carlosoliveirajesus/datalogger/hw-datalogger/fabricacao/BOM/Bill of Materials-datalogger.xlsx

Name | Description | Designator | Footprint | LibRef | Quantity
GRM219R61E475KA73D | Chip Multilayer Ceramic Capacitors for General Purpose, 0805, 4.7uF, X5R, 15%, 10%, 25V | C1 | FP-GRM219-0_15-0_1-IPC_C | CMP-06035-041247-1 | 1
GRM21BZ71E106KE15K | Chip Multilayer Ceramic Capacitors for General Purpose, 0805, 10uF, X7R, 15%, 10%, 25V | C2, C3, C4, C10, C22, C24 | FP-GRM21B-0_2-e0_2_0_7-IPC_B | CMP-06035-042430-1 | 6
CC0603KRX7R9BB104 | CAP CER 0.1UF 50V X7R 0603 | C5, C6, C9, C11, C12, C18, C19, C20, C21, C23, C26, C27, C28, C29, C30 | FP-CC0603-DA-MFG | CMP-2100-03601-2 | 15
C0402C829D5GACTU | CAP CER 8.2PF 50V C0G/NP0 0402 | C7, C8 | FP-C0402-BB-MFG | CMP-1034-00609-3 | 2
CC0603KRX7R7BB225 | CAP CER 2.2UF 16V X7R 0603 | C13, C14, C25 | FP-CC0603-DA-MFG | CMP-03422-001238-1 | 3
C0402C100C5GACTU | CAP CER 10PF 50V NP0 0402 | C15, C16 | FP-C0402-BB-MFG | CMP-2008-03045-2 | 2
GCM188R71E105KA64D |  | C17 | FP-GCM188-0_1-MFG | CMP-2006-02363-4 | 1
B5819W | Schottky Barrier Rectifier, 40 V, 1 A, -65 to 125 degC, 2-Pin SOD123, RoHS, Tape and Reel | D1 | MCC-SOD123_V | CMP-004-00005-2 | 1
APT1608SGC | Super Bright Green LED, 62.5 mW, 25 mA, -40 to 85 degC, 2-Pin SMD, RoHS, Tape and Reel | D2 | KING-APT1608SGC_V | CMP-2000-05789-1 | 1
APT1608EC | LED RED CLEAR CHIP SMD | D3 | FP-APT1608EC-MFG | CMP-2000-05179-2 | 1
APT1608QBC/D | LED BLUE CLEAR CHIP SMD | D4 | FP-APT1608QBC-D-MFG | CMP-2000-05788-2 | 1
BLM18PG221SH1D | Chip Ferrite Bead, 0603, 220Ω @ 100MHz, 0.1Ω, 25%, 1.4A | FB1 | FP-BLM18-0_15-t0_8-IPC_C | CMP-06046-000201-1 | 1
USB4105-GF-A | Conector USB-C 2.0, receptáculo de 16 pinos, montagem SMT/TH | J1 | GCT_USB4105-GF-A | USB4105-GF-A | 1
61300611121 | THT Vertical Pin Header WR-PHD, Pitch 2.54 mm, Single Row, 6 pins | J2 | 61300611121 | CMP-1502-01070-4 | 1
61300411121 | THT Vertical Pin Header WR-PHD, Pitch 2.54 mm, Single Row, 4 pins | J3 | 61300411121 | CMP-1502-01064-4 | 1
DM3AT-SF-PEJM5 | CONN MICRO SD CARD PUSH-PUSH R/A | J4 | FP-DM3AT-SF-PEJM5-MFG | CMP-2000-05150-2 | 1
VLS3012HBX-2R2M | FIXED IND 2.2UH 3.15A 106 MOHM | L1 | FP-VLS3012HBX-MFG | CMP-08253-000022-1 | 1
LQM21PN2R2MGHL | Multilayer Type Inductor for Power Lines, 0805 (2012), 2.2μH, 20%, 0.156Ω, 1.7A | L2 | FP-LQM21PH_G0-IPC_C | CMP-06042-014073-1 | 1
S2B-PH-SM4-TB(LF)(SN) | Male Header, Pitch 2 mm, 1 x 2 Position, Height 5.5 mm, -25 to 85 degC, RoHS, Tape and Reel | P1 | JST- S2B-PH-SM4-TB(LF)(SN)-2_V | CMP-002-00031-2 | 1
DMG2305UX-13 | MOSFET P-CH 20V 4.2A SOT23 | Q1 | FP-SOT23-MFG | CMP-12801-000021-1 | 1
RC0603FR-07100RL |  | R1 | FP-RC0603-0_55-MFG | CMP-2100-03663-2 | 1
RC0603FR-07100KL | RES SMD 100K OHM 1% 1/10W 0603 | R2, R5, R6 | FP-RC0603-0_55-MFG | CMP-2100-03662-2 | 3
RC0603FR-075K1L |  | R3, R4 | RESC1608X55X25ML10T15 | CMP-2000-04091-1 | 2
RC0603FR-0710KL | RES 10K OHM 1% 1/10W 0603 | R7, R18 | FP-RC0603-0_55-IPC_C | CMP-2100-03664-2 | 2
RC0603FR-074K7L | Chip Resistor, 4.7 KOhm, +/- 1%, 0.1 W, -55 to 155 degC, 0603 (1608 Metric), RoHS, Tape and Reel | R8, R9 | RESC1608X55X25LL10T15 | CMP-2000-06942-1 | 2
RC0603FR-0747KL | RES SMD 47K OHM 1% 1/10W 0603 | R10, R11, R12, R13, R14, R15 | FP-RC0603FR-0747KL-MFG | CMP-1659-00055-2 | 6
RC0603FR-0733RL | Chip Resistor, 33 Ohm, +/- 1%, 0.1 W, -55 to 155 degC, 0603 (1608 Metric), RoHS, Tape and Reel | R16 | RESC1608X55X25LL10T15 | CMP-2000-06939-1 | 1
RC0603FR-071KL | RES 1K OHM 1% 1/10W 0603 | R17, R19 | FP-RC0603-0_55-IPC_C | CMP-1659-00009-5 | 2
RT0603FRE07330RL | RES SMD 330 OHM 1% 1/10W 0603 | R20 | FP-RT0603-MFG | CMP-03412-006947-1 | 1
JS102011SAQN | SWITCH SLIDE SPDT 300MA 6V | SW1 | FP-JS102011SAQN-MFG | CMP-2000-06501-2 | 1
B3U-1000P | Tactile Switch, SPST-NO, 0.05 A, 12 V, -25 to 70 degC, 2-Pin SMD, RoHS, Tape and Reel | SW2, SW3, SW4 | OMRON-B3U-1000_V | CMP-011-00000-2 | 3
TPS63001DRCRG4 | Buck-Boost Voltage Converter with 1.8 to 5.5 V Input and 3.3 V Output, -40 to 85 degC, 10-Pin SON (DRC), Green (RoHS & no Sb/Br) | U1 | DRC10-2400X1650TP | CMP-0345-00003-1 | 1
USBLC6-2SC6 | 17V Clamp 5A (8/20Âµs) Ipp Tvs Diode Surface Mount SOT-23-6 | U2 | SOT95P280X145-6N | USBLC6-2SC6 | 1
STM32U5A5RJT6Q | ARM Microcontrollers - MCU Ultra-low-power FPU Arm Cortex-M33 MCU TrustZone, 160 | U3 | LQFP64-5W_MFG | CMP-00355-135308217-1 | 1
LSM6DSOXTR | INEMO INERTIAL MODULE: 3D ACCELE | U4 | FP-LGA-14L-DM00249496-MFG | CMP-12177-000010-1 | 1
BME280 | SENSOR PRESSURE HUMIDITY TEMP | U5 | FP-BME280-MFG | CMP-2000-05073-3 | 1
ABS07-32.768KHZ-7-T | Crystal 32.768kHz ±20ppm (Tol) 7pF FUND 70kΩ 2-Pin CSMD T/R | Y1 | FP-ABS07-MFG | CMP-27762-014373-1 | 1
ABM11W-16.0000MHZ-8-K1Z-T3 | Crystal 16MHz ±10ppm 8pF SMD-4 2mm x 1.6mm | Y2 | FP-ABM11W-MFG | CMP-27762-006513-1 | 1
