carlosoliveirajesus/datalogger/hw-datalogger/fabricacao/ExportSTEP/PCB_A1.step

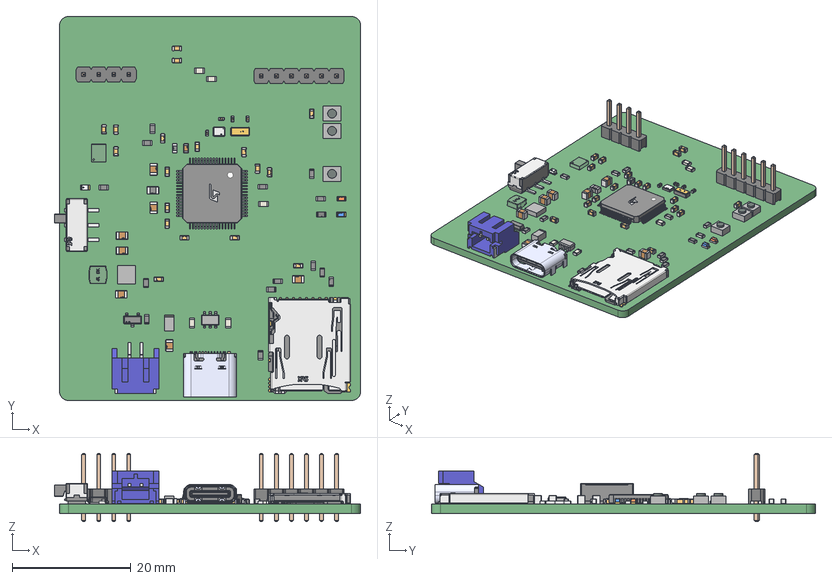
[picture p25: CAD file, 2026-10-22]
hw-datalogger/fabricacao/ExportSTEP/PCB_A1.step
51.7 x 64.8 x 11.5 mm
terminals x 8
logo x 4
Crys_Abracon_ABM11W-16_0132MHZ-4-J1Z-T3_eec x 6
Package
Leads
LID
Logo
leads
STMicroelectronics
circle
STMicroelectronics STM32F303RET61
STMicroelectronics STM32F303RET62 x 64
STM ll
Extruded x 22
shield
actuator
RT0603BRD07104KL_Ceramic
RT0603BRD07104KL_Terminal x 2
RT0603BRD07104KL_Coating
RT0603BRD07104KL_Logo
Yageo Logo x 14
pins
part number & logo
S2B-PH-SM4-TB
plat1
plat2
sides
TDK Logo
DM3AT-SF-PEJM5
Hirose Logo adjastable
6130xx11121_PIN x 10
USB4105GFA_USB4105GFA
side x 16
Murata x 8
base x 2
lens x 2
cathode mark x 2
APT1608
name x 18
Murata Logo 3
value x 4
