carlosoliveirajesus/datalogger/hw-datalogger/fabricacao/dataloggerOutJob.PDF

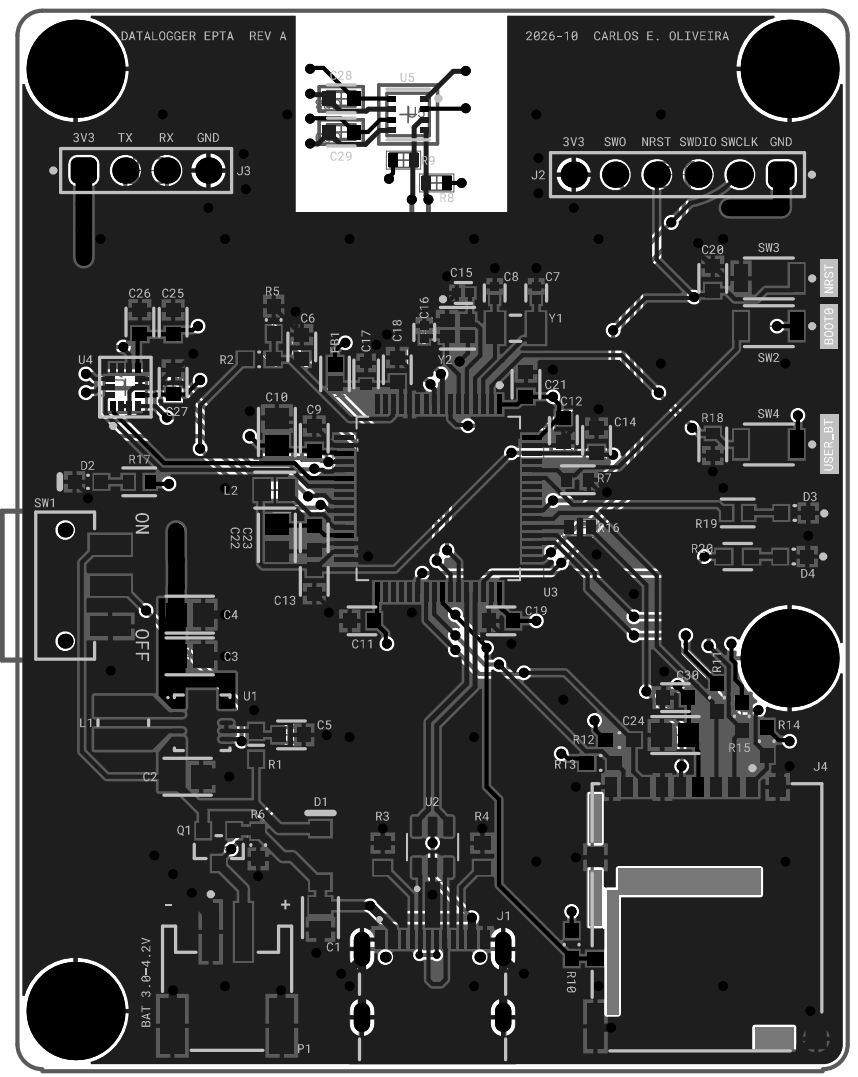
[picture p26: page 1]

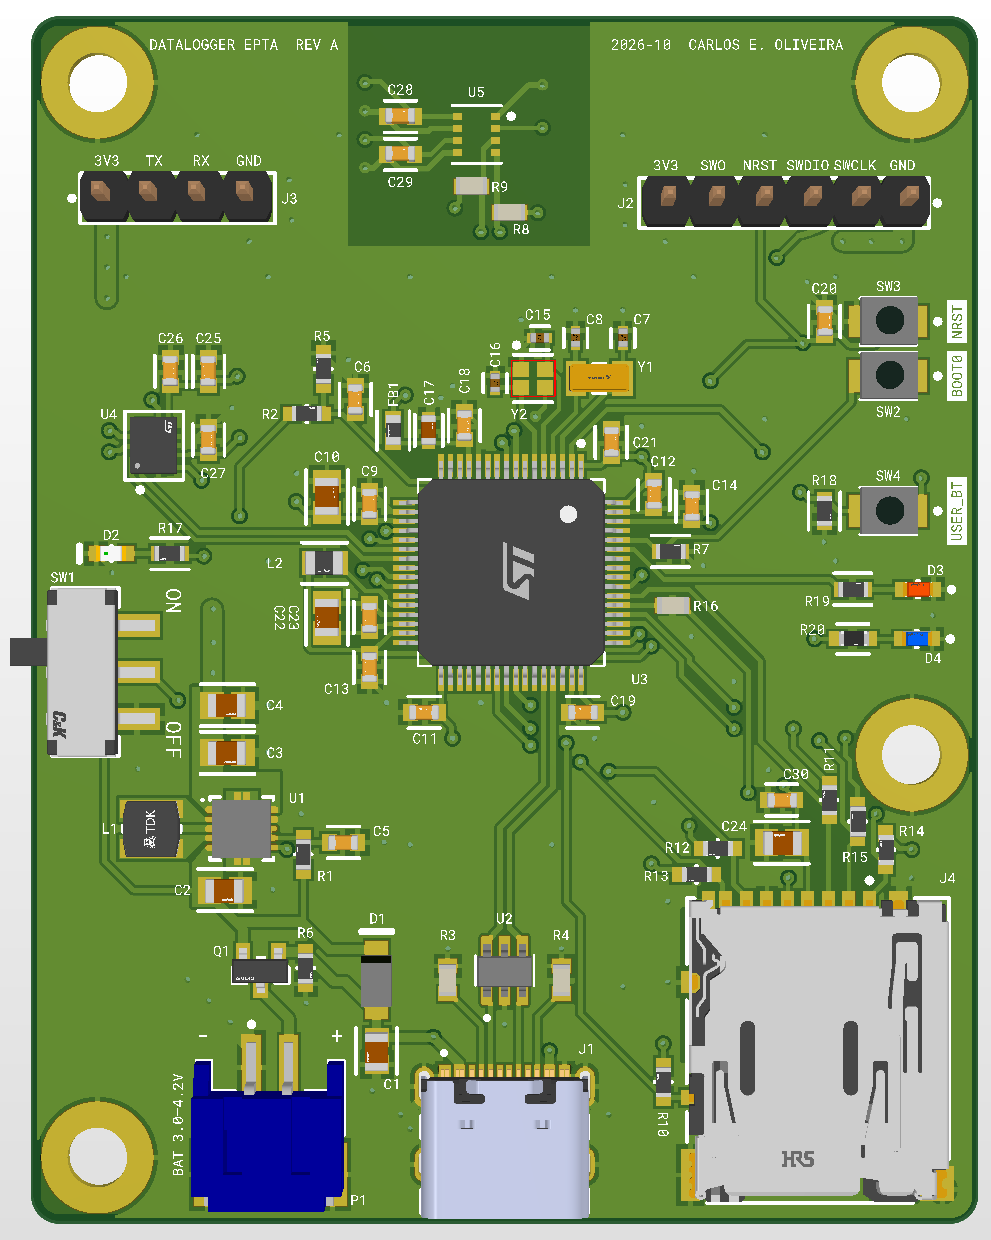
[picture p27: page 2]

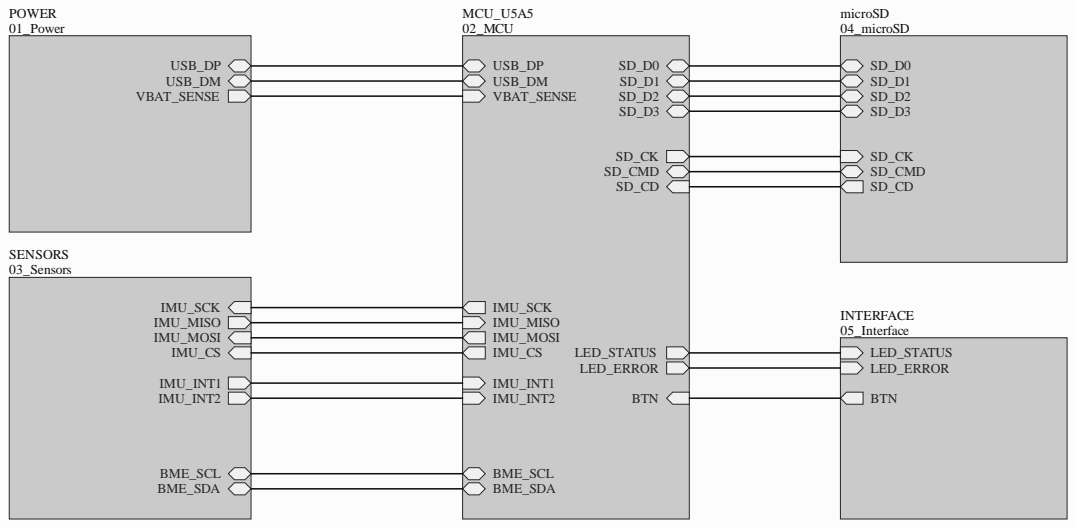
[picture p28: page 3]

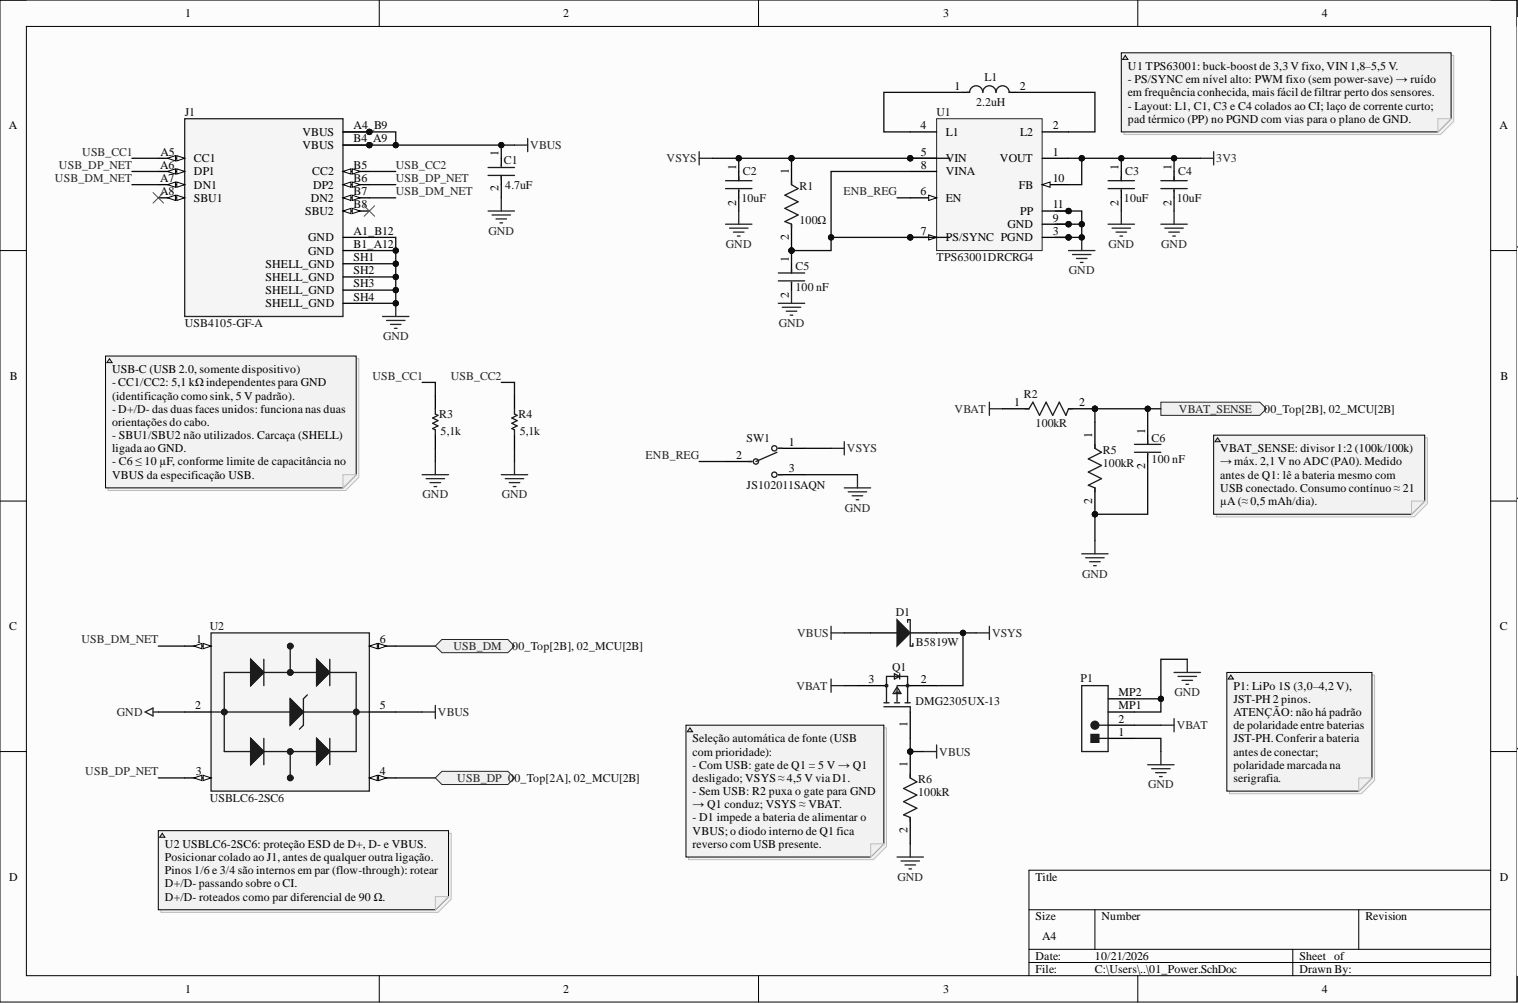
[picture p29: page 4]

U1 TPS63001: buck-boost de 3,3 V fixo, VIN 1,8–5,5 V.
- PS/SYNC em nível alto: PWM fixo (sem power-save) → ruído
em frequência conhecida, mais fácil de filtrar perto dos sensores.
- Layout: L1, C1, C3 e C4 colados ao CI; laço de corrente curto;
pad térmico (PP) no PGND com vias para o plano de GND.

USB-C (USB 2.0, somente dispositivo)
- CC1/CC2: 5,1 kΩ independentes para GND
(identificação como sink, 5 V padrão).
- D+/D- das duas faces unidos: funciona nas duas
orientações do cabo.
- SBU1/SBU2 não utilizados. Carcaça (SHELL)
ligada ao GND.
- C6 ≤ 10 µF, conforme limite de capacitância no
VBUS da especificação USB.

VBAT_SENSE: divisor 1:2 (100k/100k)
→ máx. 2,1 V no ADC (PA0). Medido
antes de Q1: lê a bateria mesmo com
USB conectado. Consumo contínuo ≈ 21
µA (≈ 0,5 mAh/dia).

P1: LiPo 1S (3,0–4,2 V),
JST-PH 2 pinos.
ATENÇÃO: não há padrão
de polaridade entre baterias
JST-PH. Conferir a bateria
antes de conectar;
polaridade marcada na
serigrafia.

Seleção automática de fonte (USB
com prioridade):
- Com USB: gate de Q1 = 5 V → Q1
desligado; VSYS ≈ 4,5 V via D1.
- Sem USB: R2 puxa o gate para GND
→ Q1 conduz; VSYS ≈ VBAT.
- D1 impede a bateria de alimentar o
VBUS; o diodo interno de Q1 fica
reverso com USB presente.

U2 USBLC6-2SC6: proteção ESD de D+, D- e VBUS.
Posicionar colado ao J1, antes de qualquer outra ligação.
Pinos 1/6 e 3/4 são internos em par (flow-through): rotear
D+/D- passando sobre o CI.
D+/D- roteados como par diferencial de 90 Ω.

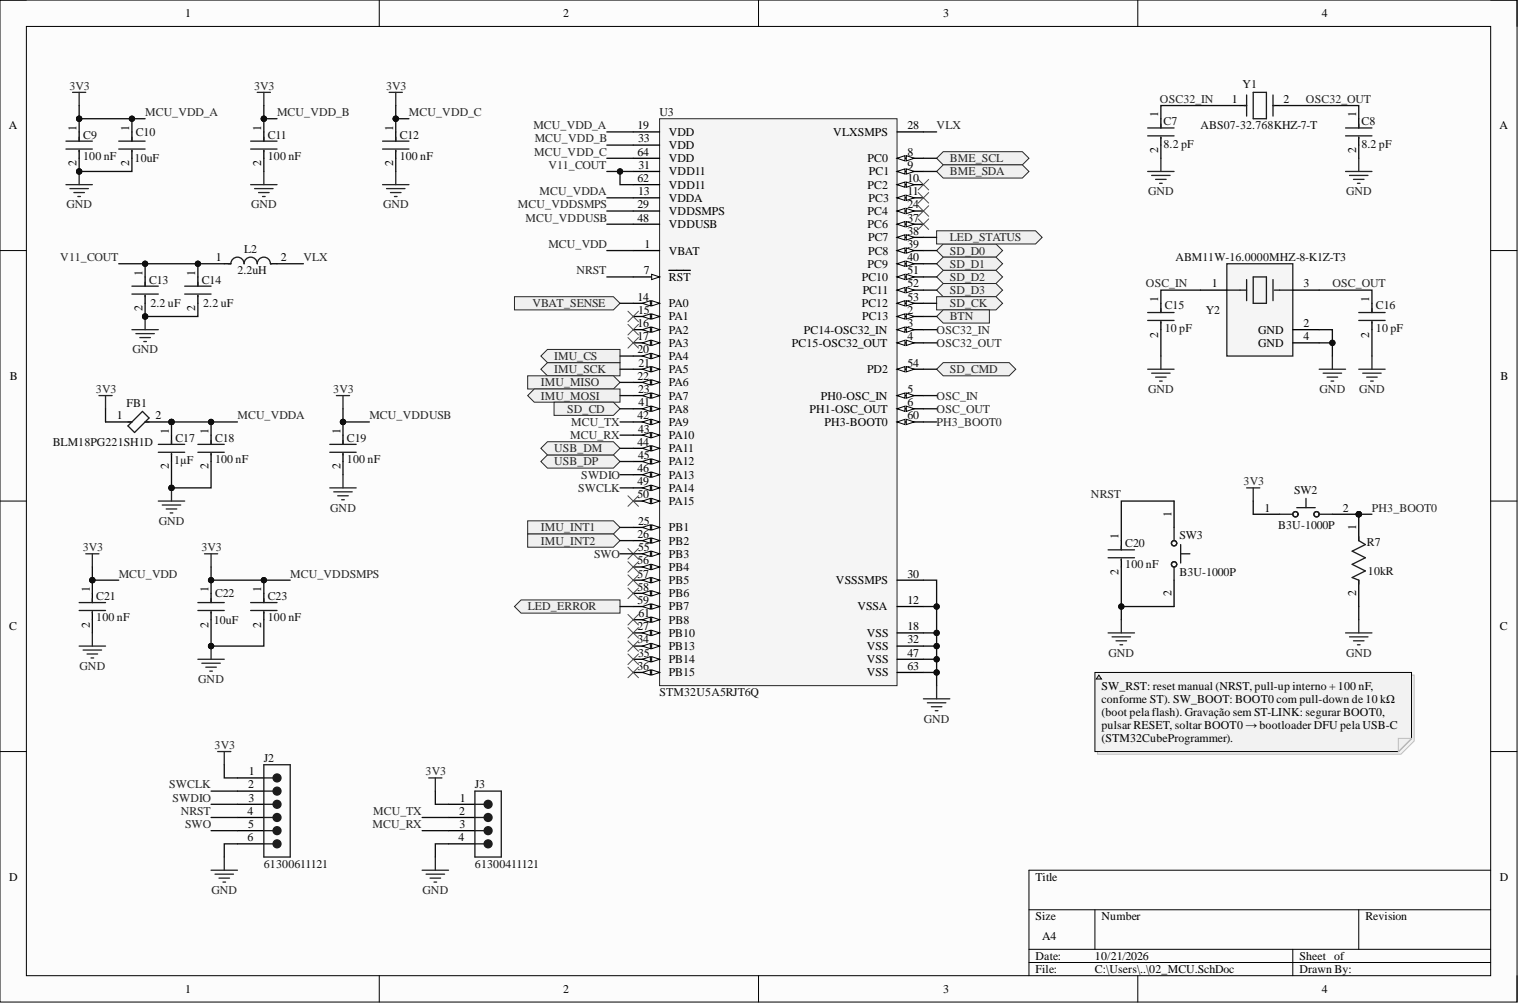
[picture p30: page 5]

SW_RST: reset manual (NRST, pull-up interno + 100 nF,
conforme ST). SW_BOOT: BOOT0 com pull-down de 10 kΩ
(boot pela flash). Gravação sem ST-LINK: segurar BOOT0,
pulsar RESET, soltar BOOT0 → bootloader DFU pela USB-C
(STM32CubeProgrammer).

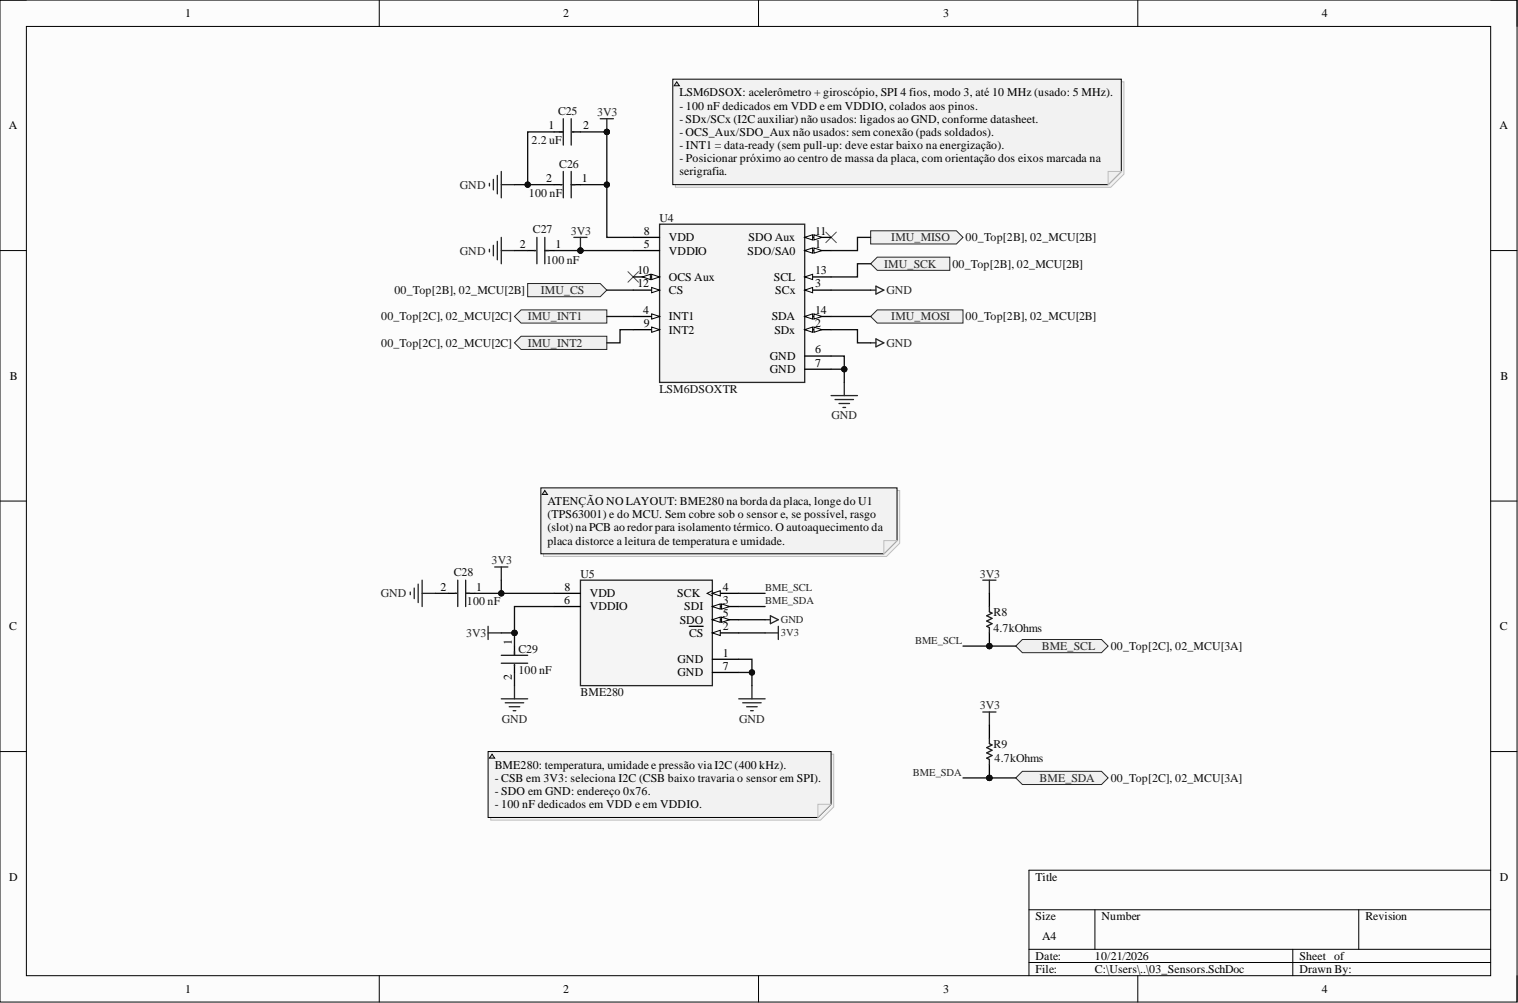
[picture p31: page 6]

LSM6DSOX: acelerômetro + giroscópio, SPI 4 fios, modo 3, até 10 MHz (usado: 5 MHz).
- 100 nF dedicados em VDD e em VDDIO, colados aos pinos.
- SDx/SCx (I2C auxiliar) não usados: ligados ao GND, conforme datasheet.
- OCS_Aux/SDO_Aux não usados: sem conexão (pads soldados).
- INT1 = data-ready (sem pull-up: deve estar baixo na energização).
- Posicionar próximo ao centro de massa da placa, com orientação dos eixos marcada na
serigrafia.

ATENÇÃO NO LAYOUT: BME280 na borda da placa, longe do U1
(TPS63001) e do MCU. Sem cobre sob o sensor e, se possível, rasgo
(slot) na PCB ao redor para isolamento térmico. O autoaquecimento da
placa distorce a leitura de temperatura e umidade.

BME280: temperatura, umidade e pressão via I2C (400 kHz).
- CSB em 3V3: seleciona I2C (CSB baixo travaria o sensor em SPI).
- SDO em GND: endereço 0x76.
- 100 nF dedicados em VDD e em VDDIO.

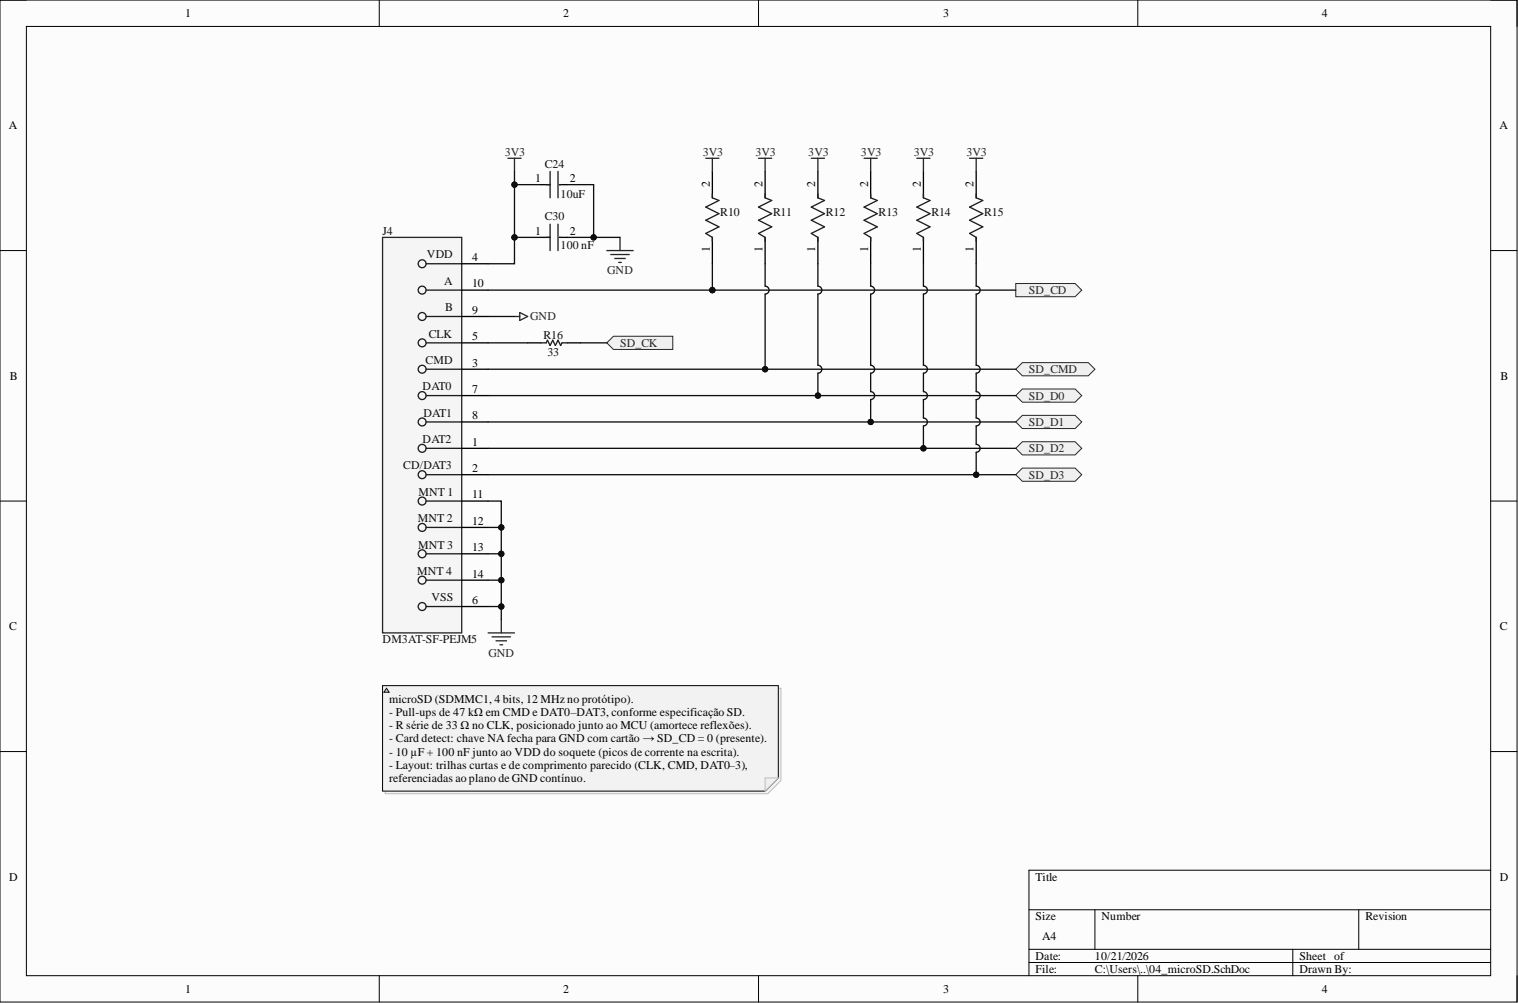
[picture p32: page 7]

microSD (SDMMC1, 4 bits, 12 MHz no protótipo).
- Pull-ups de 47 kΩ em CMD e DAT0–DAT3, conforme especificação SD.
- R série de 33 Ω no CLK, posicionado junto ao MCU (amortece reflexões).
- Card detect: chave NA fecha para GND com cartão → SD_CD = 0 (presente).
- 10 µF + 100 nF junto ao VDD do soquete (picos de corrente na escrita).
- Layout: trilhas curtas e de comprimento parecido (CLK, CMD, DAT0–3),
referenciadas ao plano de GND contínuo.

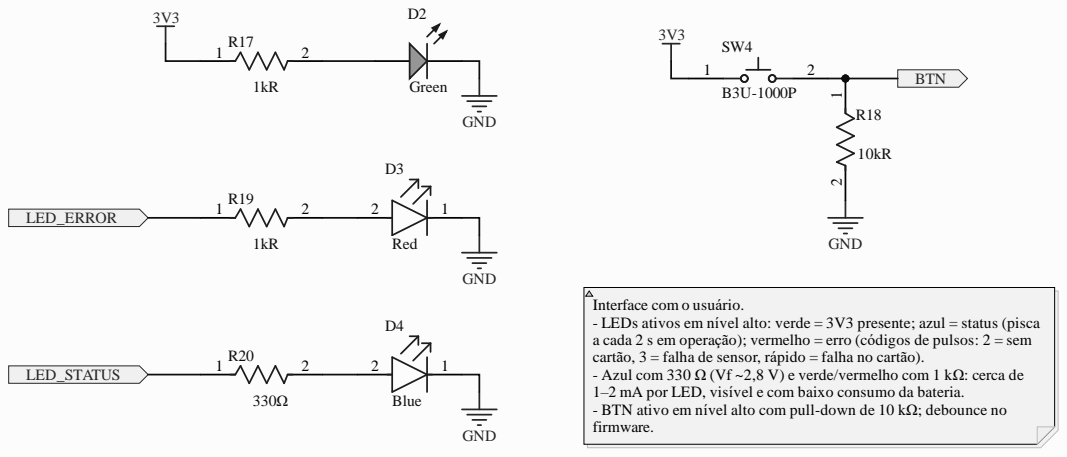
[picture p33: page 8]

Interface com o usuário.
- LEDs ativos em nível alto: verde = 3V3 presente; azul = status (pisca
a cada 2 s em operação); vermelho = erro (códigos de pulsos: 2 = sem
cartão, 3 = falha de sensor, rápido = falha no cartão).
- Azul com 330 Ω (Vf ~2,8 V) e verde/vermelho com 1 kΩ: cerca de
1–2 mA por LED, visível e com baixo consumo da bateria.
- BTN ativo em nível alto com pull-down de 10 kΩ; debounce no
firmware.
