carlosoliveirajesus/datalogger/docs/testes/csv/LOG_0002.CSV

t_ms | ax_g | ay_g | az_g | gx_dps | gy_dps | gz_dps | temp_c | press_hpa | hum_rh
6141.561 | -0.2904 | 0.0020 | 0.9809 | 0.21 | -0.07 | 0.00 | 25.14 | 912.42 | 37.0
6160.845 | -0.2908 | -0.0024 | 0.9823 | 1.05 | -0.49 | 0.35 | 25.14 | 912.42 | 37.0
6168.077 | -0.2894 | -0.0020 | 0.9799 | 0.84 | -0.49 | 0.42 | 25.14 | 912.42 | 37.0
6184.950 | -0.2982 | -0.0073 | 0.9643 | -6.58 | 1.96 | 3.15 | 25.14 | 912.42 | 37.0
6189.771 | -0.2948 | 0.0029 | 0.9536 | -2.94 | -2.03 | -3.71 | 25.14 | 912.42 | 37.0
6230.749 | -0.2957 | -0.0049 | 0.9701 | 1.75 | 0.63 | -3.92 | 25.14 | 912.44 | 37.0
6266.906 | -0.2816 | -0.0015 | 0.9882 | 0.14 | 0.49 | -1.26 | 25.14 | 912.44 | 37.0
6278.958 | -0.2840 | -0.0024 | 0.9848 | 0.35 | -0.14 | 0.21 | 25.14 | 912.44 | 37.0
6336.810 | -0.2826 | 0.0010 | 0.9833 | 1.19 | 0.28 | -0.21 | 25.15 | 912.44 | 37.0
6356.094 | -0.2913 | -0.0083 | 0.9804 | 0.77 | -0.28 | 0.49 | 25.15 | 912.44 | 37.0
6363.325 | -0.2913 | -0.0073 | 0.9760 | 0.07 | -0.28 | 0.63 | 25.14 | 912.43 | 37.0
6401.893 | -0.2894 | 0.0029 | 0.9809 | 0.14 | 0.14 | 0.21 | 25.14 | 912.43 | 37.0
6406.713 | -0.2904 | 0.0029 | 0.9780 | 0.63 | 0.14 | 0.07 | 25.14 | 912.43 | 37.0
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
