carlosoliveirajesus/datalogger/docs/testes/csv/LOG_0003.CSV

t_ms | ax_g | ay_g | az_g | gx_dps | gy_dps | gz_dps | temp_c | press_hpa | hum_rh
2424.694 | -0.1108 | -0.0195 | 1.0175 | 0.21 | 0.21 | 0.35 | 25.16 | 912.48 | 35.9
2427.104 | -0.1103 | -0.0220 | 1.0185 | 0.35 | 0.21 | 0.28 | 25.16 | 912.48 | 35.9
2429.515 | -0.1093 | -0.0239 | 1.0165 | 0.35 | 0.07 | 0.14 | 25.16 | 912.48 | 35.9
2431.925 | -0.1108 | -0.0234 | 1.0160 | 0.42 | 0.14 | 0.00 | 25.16 | 912.48 | 35.9
2434.336 | -0.1083 | -0.0239 | 1.0180 | 0.42 | 0.14 | 0.00 | 25.16 | 912.48 | 35.9
2436.746 | -0.1118 | -0.0234 | 1.0165 | 0.35 | 0.07 | -0.07 | 25.16 | 912.48 | 35.9
2439.157 | -0.1064 | -0.0224 | 1.0146 | 0.42 | 0.07 | -0.14 | 25.16 | 912.48 | 35.9
2441.567 | -0.1069 | -0.0264 | 1.0170 | 0.77 | 0.00 | -0.28 | 25.16 | 912.48 | 35.9
2443.978 | -0.1059 | -0.0244 | 1.0160 | 0.70 | -0.07 | -0.28 | 25.16 | 912.48 | 35.9
2446.388 | -0.1054 | -0.0298 | 1.0160 | 0.70 | -0.14 | -0.14 | 25.16 | 912.48 | 35.9
2448.798 | -0.1093 | -0.0254 | 1.0175 | 0.56 | -0.28 | -0.14 | 25.16 | 912.48 | 35.9
2451.209 | -0.1098 | -0.0259 | 1.0160 | 0.42 | -0.28 | 0.00 | 25.16 | 912.48 | 35.9
2453.619 | -0.1098 | -0.0259 | 1.0194 | 0.42 | -0.35 | -0.21 | 25.16 | 912.49 | 35.9
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
