carlosoliveirajesus/datalogger/docs/testes/csv/LOG_0004.CSV

t_ms | ax_g | ay_g | az_g | gx_dps | gy_dps | gz_dps | temp_c | press_hpa | hum_rh
2627.086 | -0.2865 | 0.0029 | 0.9819 | 0.35 | 0.42 | -0.28 | 26.31 | 912.42 | 35.1
2629.496 | -0.2860 | 0.0005 | 0.9809 | 0.35 | 0.28 | -0.21 | 26.31 | 912.42 | 35.1
2631.907 | -0.2874 | -0.0024 | 0.9828 | 0.28 | 0.35 | -0.14 | 26.31 | 912.42 | 35.1
2634.317 | -0.2865 | -0.0020 | 0.9804 | 0.14 | 0.28 | -0.14 | 26.31 | 912.42 | 35.1
2636.728 | -0.2860 | 0.0000 | 0.9784 | 0.21 | 0.21 | -0.07 | 26.31 | 912.42 | 35.1
2639.138 | -0.2835 | 0.0000 | 0.9794 | 0.14 | 0.28 | 0.00 | 26.31 | 912.42 | 35.1
2641.548 | -0.2869 | -0.0020 | 0.9804 | 0.07 | 0.21 | 0.07 | 26.31 | 912.42 | 35.1
2643.959 | -0.2850 | 0.0010 | 0.9814 | 0.07 | 0.14 | 0.21 | 26.31 | 912.42 | 35.1
2646.369 | -0.2865 | 0.0015 | 0.9780 | -0.07 | 0.07 | 0.14 | 26.31 | 912.42 | 35.1
2648.780 | -0.2865 | 0.0000 | 0.9780 | -0.07 | 0.07 | 0.00 | 26.31 | 912.42 | 35.1
2651.190 | -0.2845 | 0.0005 | 0.9775 | -0.07 | 0.00 | 0.07 | 26.31 | 912.42 | 35.1
2653.600 | -0.2869 | 0.0024 | 0.9765 | -0.14 | 0.00 | 0.00 | 26.31 | 912.42 | 35.1
2656.011 | -0.2865 | 0.0029 | 0.9770 | 0.00 | -0.14 | 0.00 | 26.31 | 912.42 | 35.1
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
