carlosoliveirajesus/datalogger/docs/testes/csv/LOG_0005.CSV

t_ms | ax_g | ay_g | az_g | gx_dps | gy_dps | gz_dps | temp_c | press_hpa | hum_rh
5551.609 | -0.2416 | 0.0278 | 0.9945 | -0.21 | -0.56 | 0.21 | 24.11 | 912.66 | 41.0
5554.019 | -0.2411 | 0.0303 | 0.9892 | -0.07 | -0.49 | 0.21 | 24.11 | 912.66 | 41.0
5556.430 | -0.2420 | 0.0273 | 0.9921 | 0.14 | -0.42 | 0.14 | 24.11 | 912.66 | 41.0
5558.840 | -0.2377 | 0.0288 | 0.9911 | 0.35 | -0.07 | 0.07 | 24.11 | 912.66 | 41.0
5561.251 | -0.2377 | 0.0283 | 0.9945 | 0.63 | 0.00 | 0.00 | 24.11 | 912.66 | 41.0
5563.661 | -0.2396 | 0.0239 | 0.9911 | 0.84 | 0.14 | -0.14 | 24.11 | 912.66 | 41.0
5566.072 | -0.2386 | 0.0244 | 0.9931 | 1.05 | 0.14 | -0.35 | 24.11 | 912.66 | 41.0
5568.482 | -0.2391 | 0.0234 | 0.9955 | 1.26 | 0.14 | -0.49 | 24.11 | 912.66 | 41.0
5570.893 | -0.2391 | 0.0249 | 0.9950 | 1.19 | 0.28 | -0.42 | 24.11 | 912.66 | 41.0
5573.303 | -0.2372 | 0.0244 | 0.9936 | 1.12 | 0.28 | -0.35 | 24.11 | 912.66 | 41.0
5575.714 | -0.2362 | 0.0215 | 0.9936 | 1.26 | 0.42 | -0.42 | 24.11 | 912.66 | 41.0
5578.124 | -0.2381 | 0.0205 | 0.9955 | 1.33 | 0.49 | -0.35 | 24.11 | 912.66 | 41.0
5580.534 | -0.2338 | 0.0185 | 0.9941 | 1.33 | 0.49 | -0.28 | 24.11 | 912.66 | 41.0
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
