carlosoliveirajesus/datalogger/docs/testes/csv/LOG_0006.CSV

t_ms | ax_g | ay_g | az_g | gx_dps | gy_dps | gz_dps | temp_c | press_hpa | hum_rh
11222.932 | -0.2284 | 0.0112 | 0.9936 | 0.21 | -0.14 | -0.07 | 24.41 | 912.58 | 39.1
11225.342 | -0.2279 | 0.0137 | 0.9945 | 0.21 | -0.21 | -0.07 | 24.41 | 912.58 | 39.1
11227.753 | -0.2308 | 0.0117 | 0.9936 | 0.21 | -0.21 | -0.07 | 24.41 | 912.58 | 39.1
11230.163 | -0.2274 | 0.0127 | 0.9950 | 0.14 | -0.28 | -0.07 | 24.41 | 912.58 | 39.1
11232.574 | -0.2298 | 0.0137 | 0.9941 | 0.14 | -0.28 | 0.07 | 24.41 | 912.58 | 39.1
11234.984 | -0.2318 | 0.0127 | 0.9955 | 0.21 | -0.21 | 0.00 | 24.41 | 912.58 | 39.1
11237.395 | -0.2338 | 0.0117 | 0.9960 | 0.21 | -0.28 | 0.00 | 24.41 | 912.58 | 39.1
11239.805 | -0.2328 | 0.0132 | 0.9955 | 0.21 | -0.35 | 0.00 | 24.41 | 912.58 | 39.1
11242.216 | -0.2333 | 0.0132 | 0.9950 | 0.21 | -0.35 | -0.07 | 24.41 | 912.58 | 39.1
11244.626 | -0.2318 | 0.0151 | 0.9950 | 0.21 | -0.28 | -0.07 | 24.41 | 912.58 | 39.1
11247.037 | -0.2342 | 0.0107 | 0.9945 | 0.21 | -0.35 | -0.07 | 24.41 | 912.58 | 39.1
11249.447 | -0.2303 | 0.0137 | 0.9970 | 0.28 | -0.28 | -0.07 | 24.41 | 912.58 | 39.1
11251.858 | -0.2294 | 0.0122 | 0.9980 | 0.28 | -0.21 | -0.07 | 24.41 | 912.59 | 39.1
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
