carlosoliveirajesus/datalogger/docs/testes/graficos/LOG_0002.png

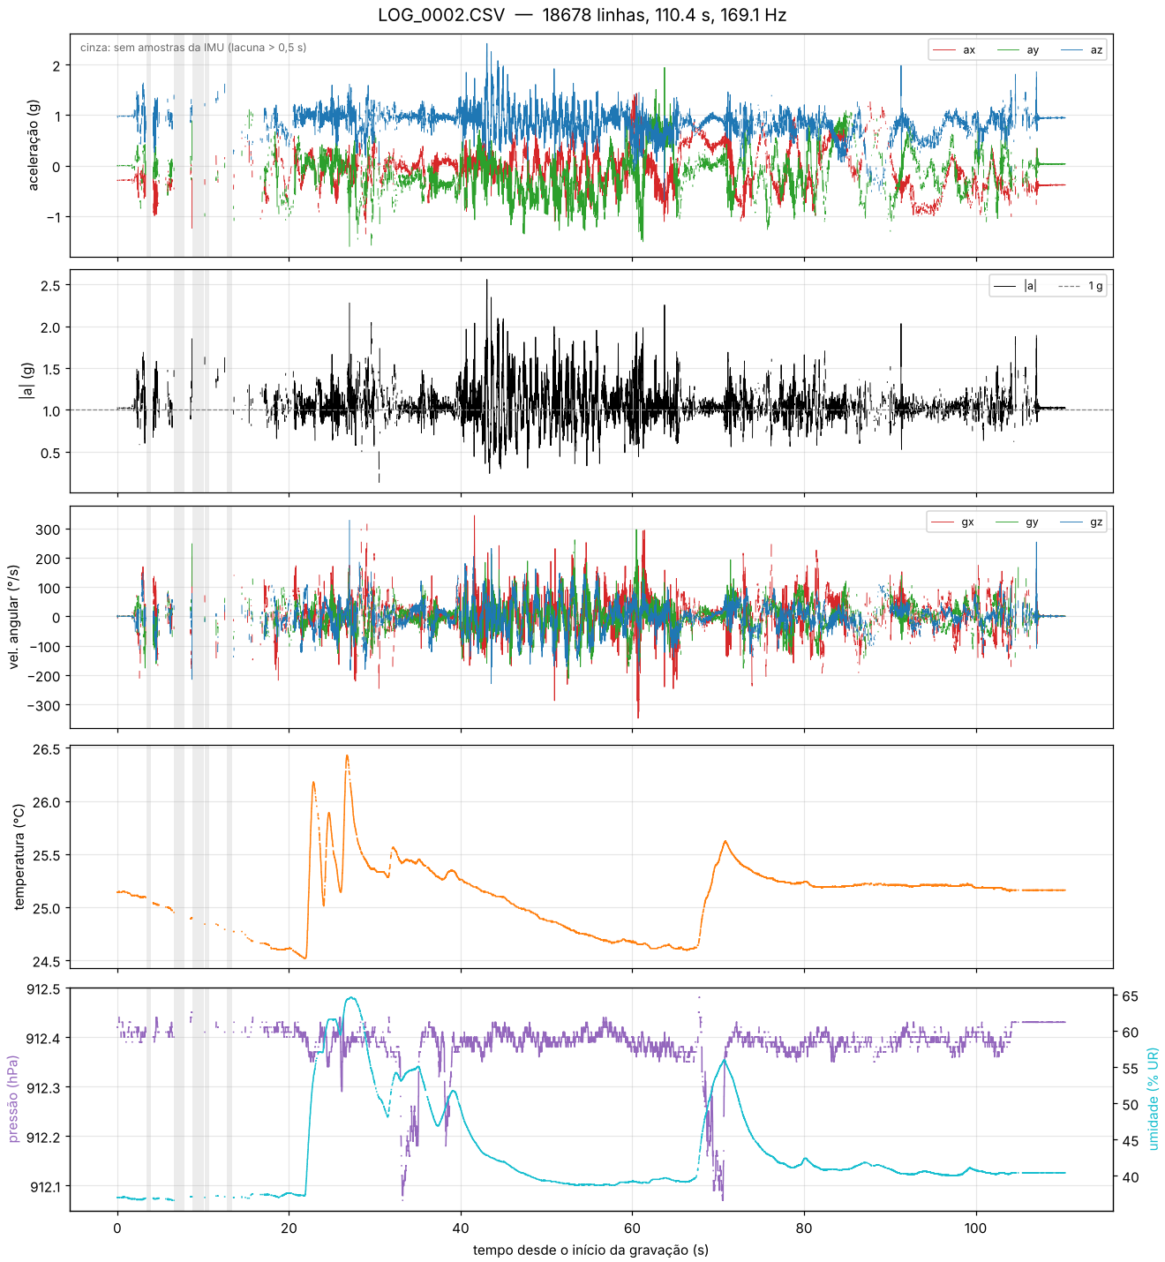
docs/testes/graficos/LOG_0002.png
