carlosoliveirajesus/datalogger/docs/testes/graficos/LOG_0003.png

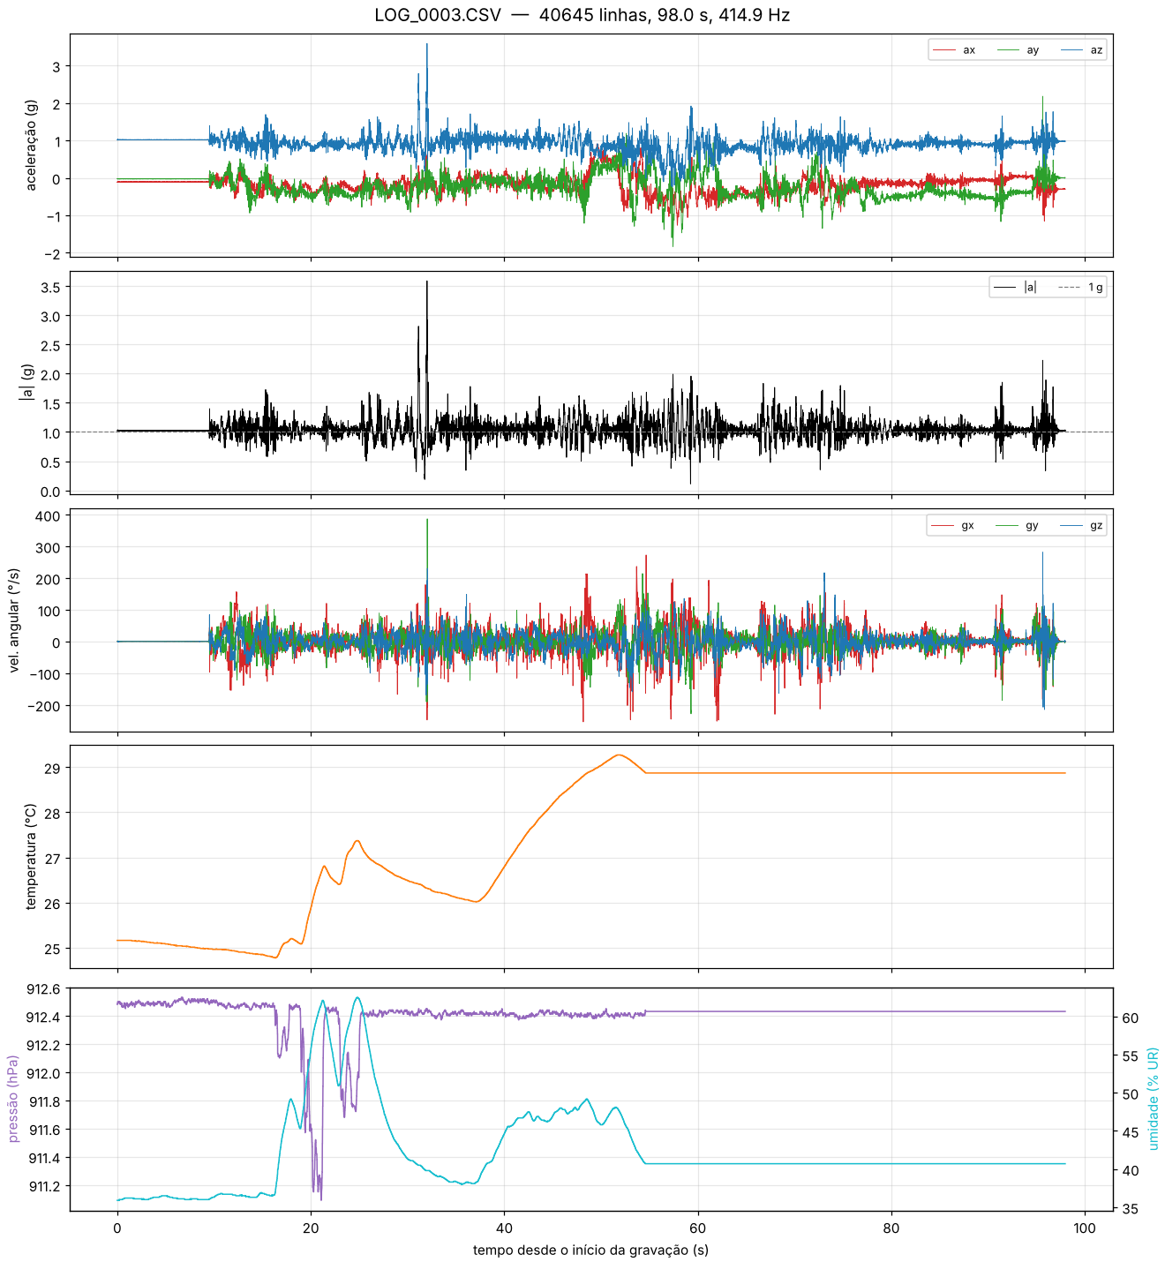
docs/testes/graficos/LOG_0003.png
