carlosoliveirajesus/datalogger/docs/testes/graficos/LOG_0004.png

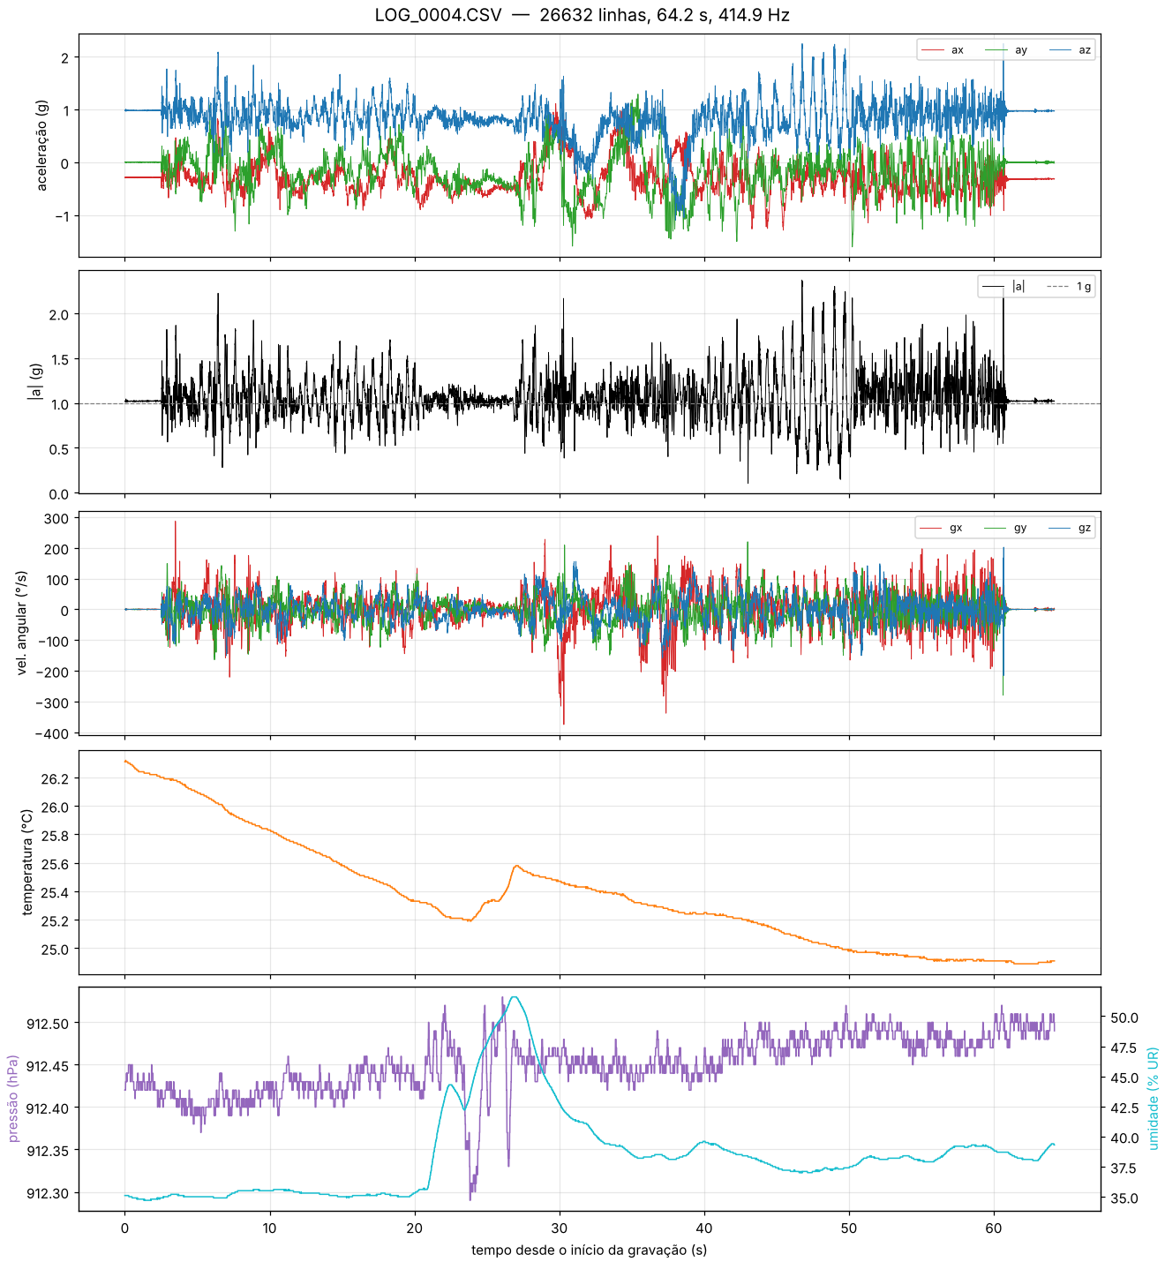
docs/testes/graficos/LOG_0004.png
