carlosoliveirajesus/datalogger/docs/testes/graficos/LOG_0005.png

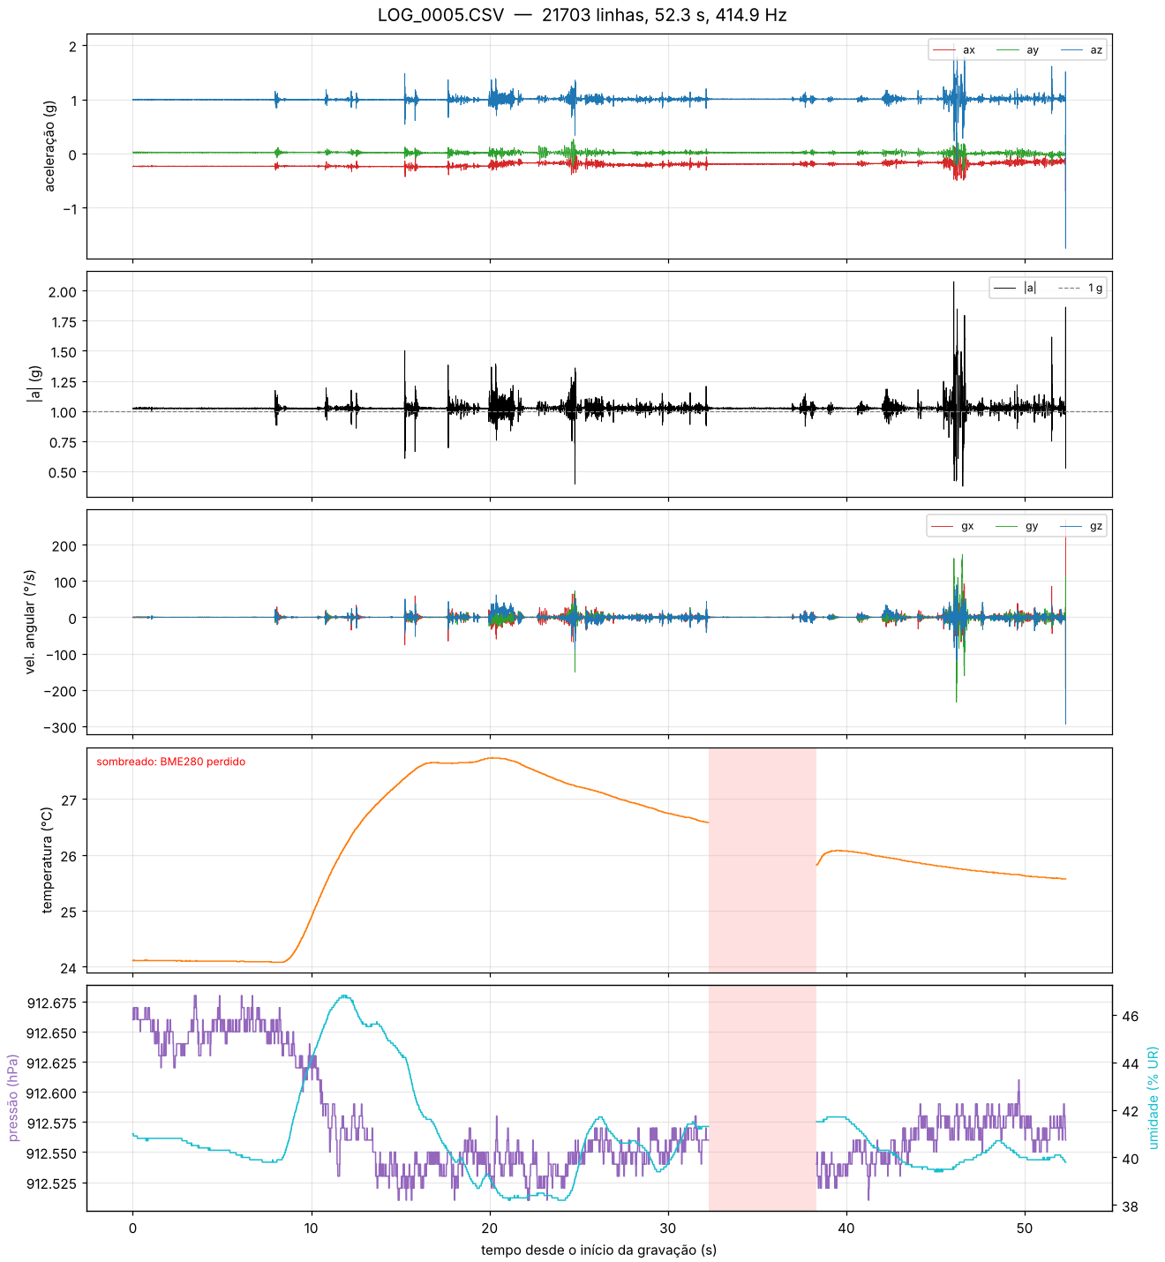
docs/testes/graficos/LOG_0005.png
