carlosoliveirajesus/datalogger/docs/testes/graficos/LOG_0007.png

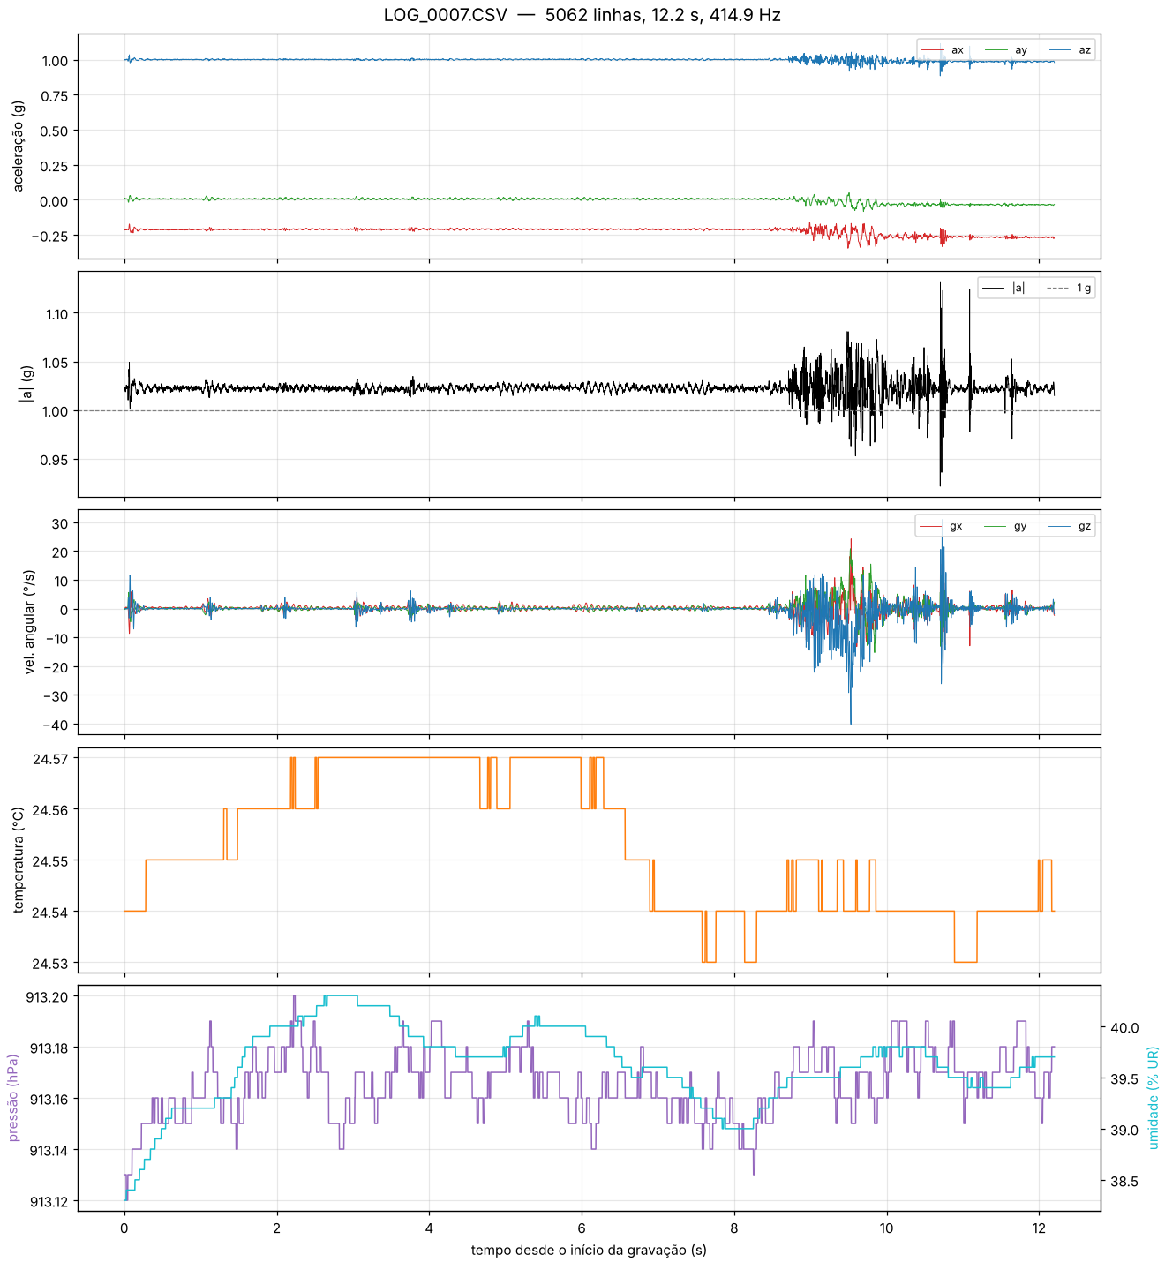
docs/testes/graficos/LOG_0007.png
