carlosoliveirajesus/datalogger/docs/testes/graficos/LOG_0008.png

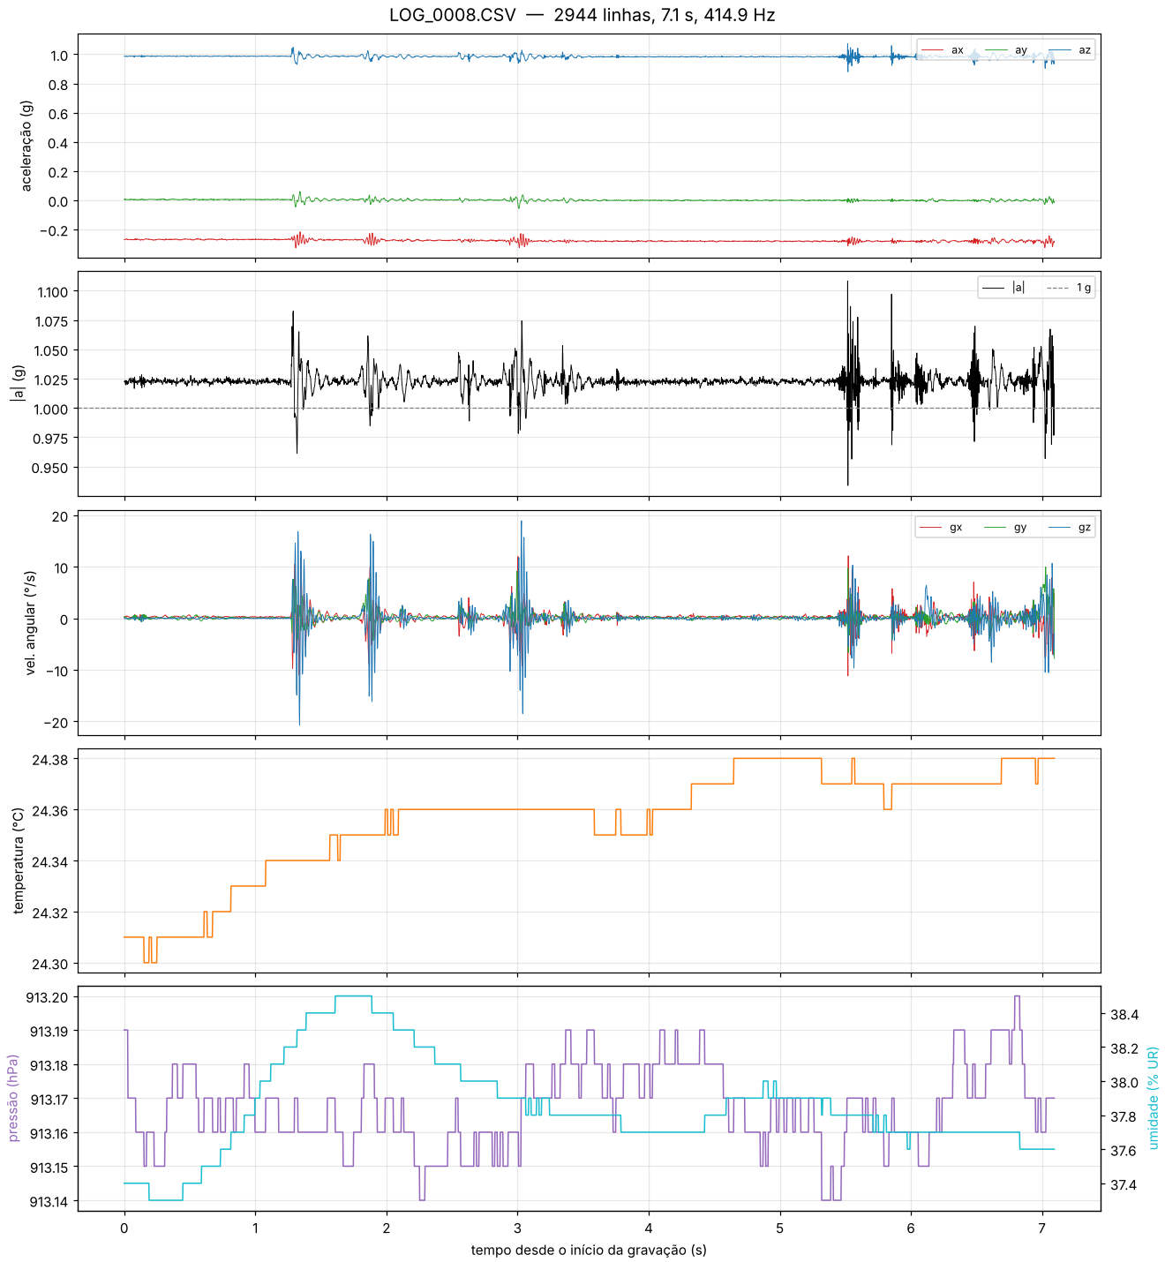
docs/testes/graficos/LOG_0008.png
