carlosoliveirajesus/datalogger/docs/testes/graficos/LOG_0009.png

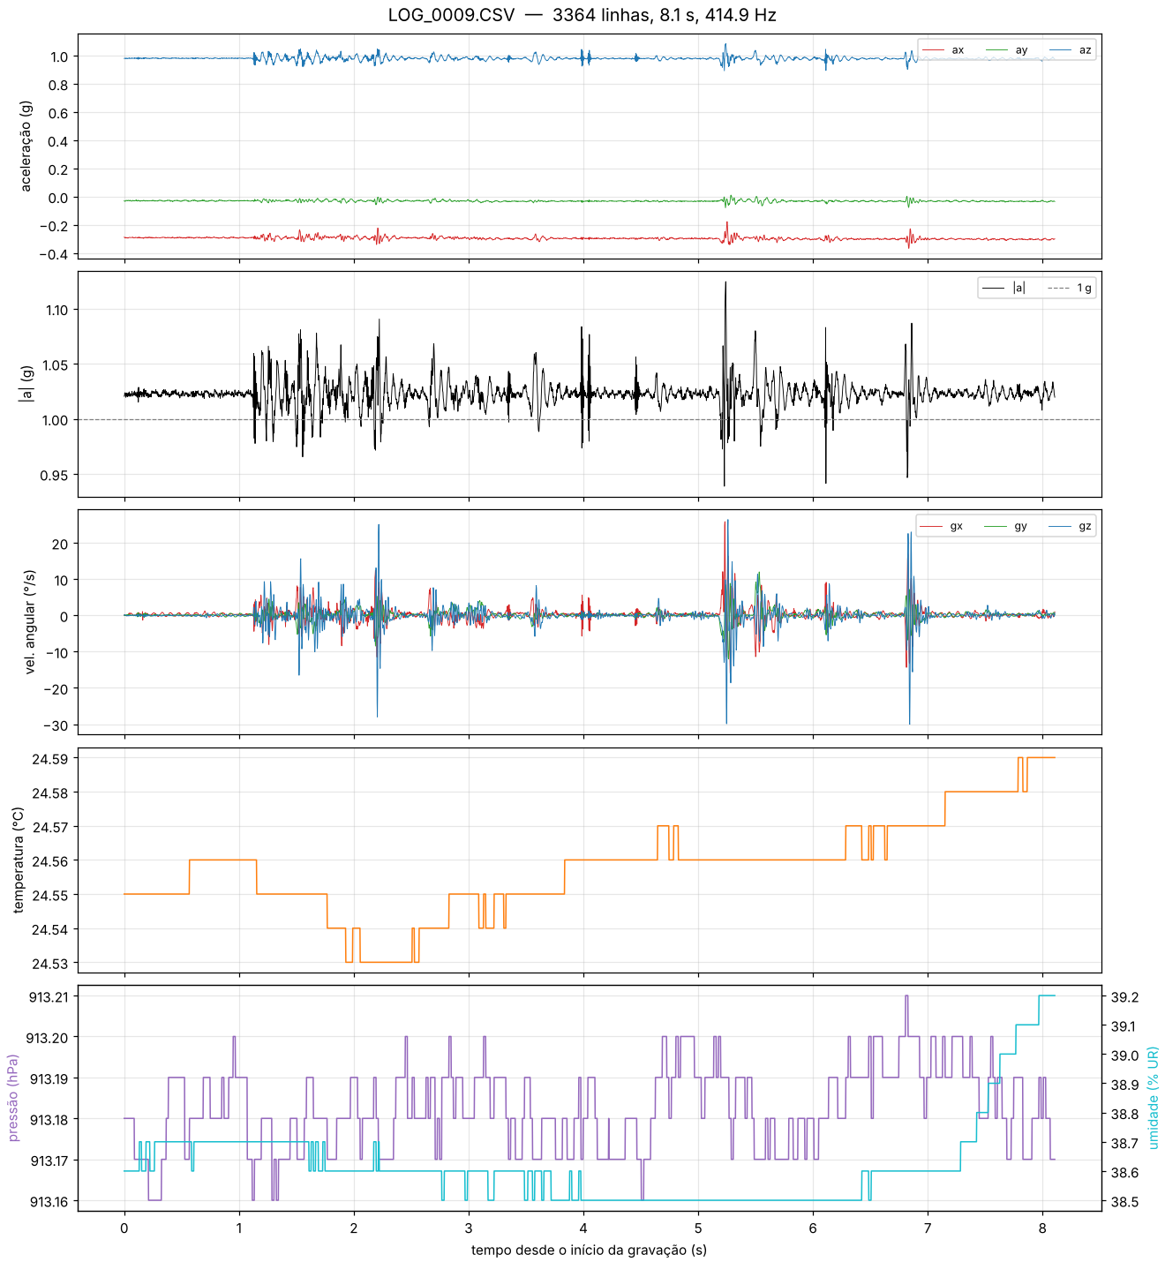
docs/testes/graficos/LOG_0009.png
