carlosoliveirajesus/datalogger/docs/testes/graficos/LOG_0010.png

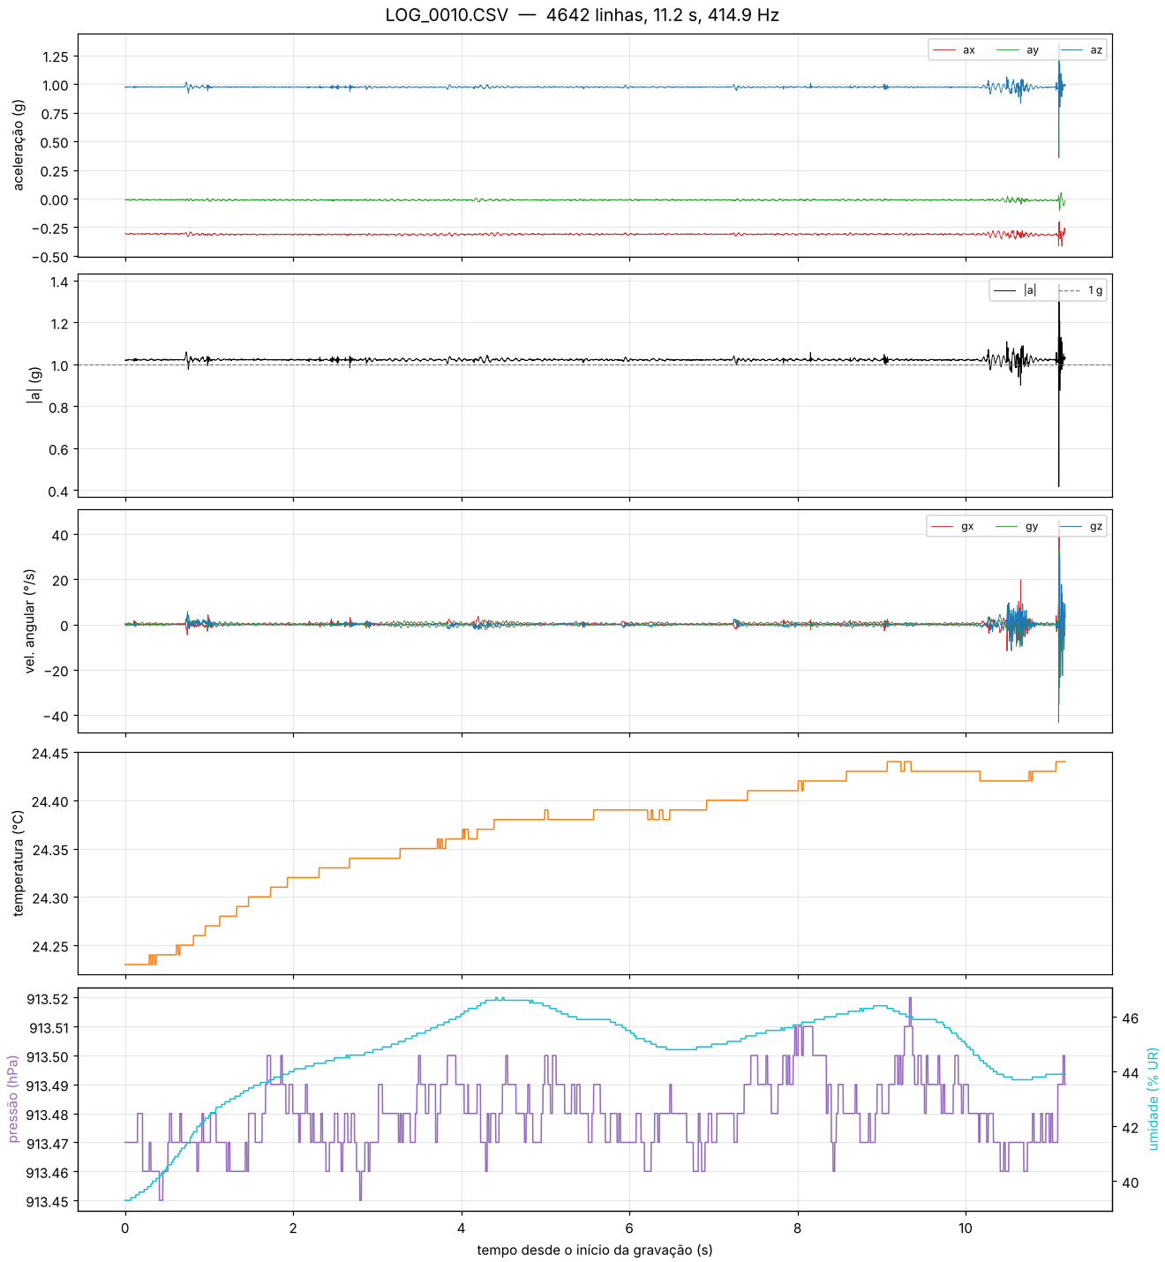
docs/testes/graficos/LOG_0010.png
