carlosoliveirajesus/datalogger/docs/testes/graficos/LOG_0011.png

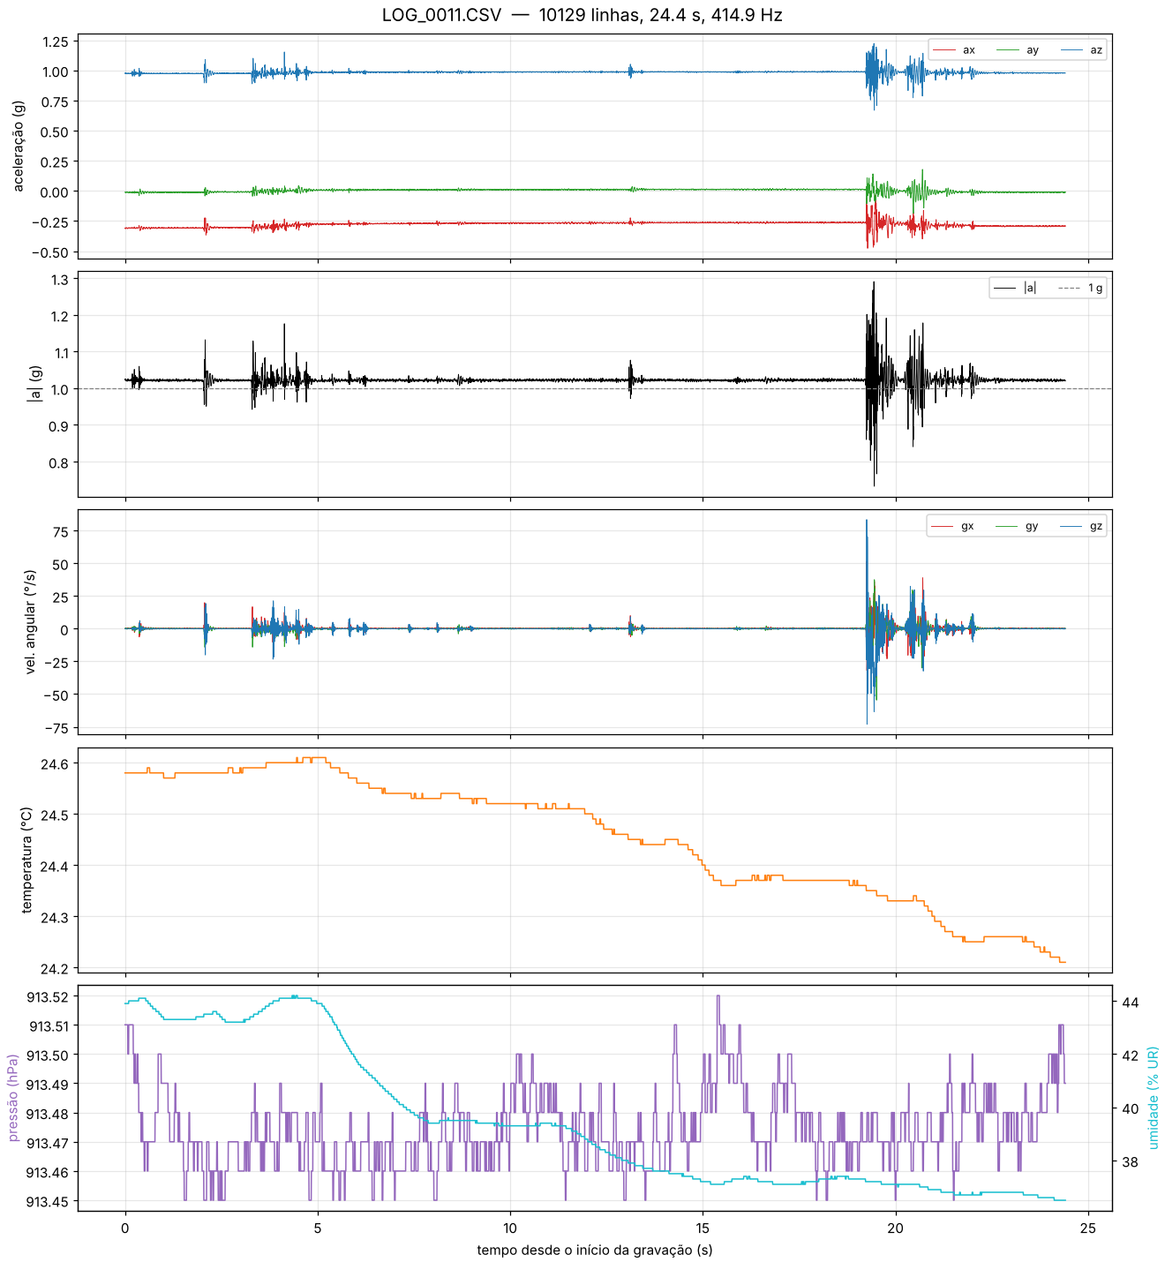
docs/testes/graficos/LOG_0011.png
