carlosoliveirajesus/datalogger/docs/testes/graficos/LOG_0012.png

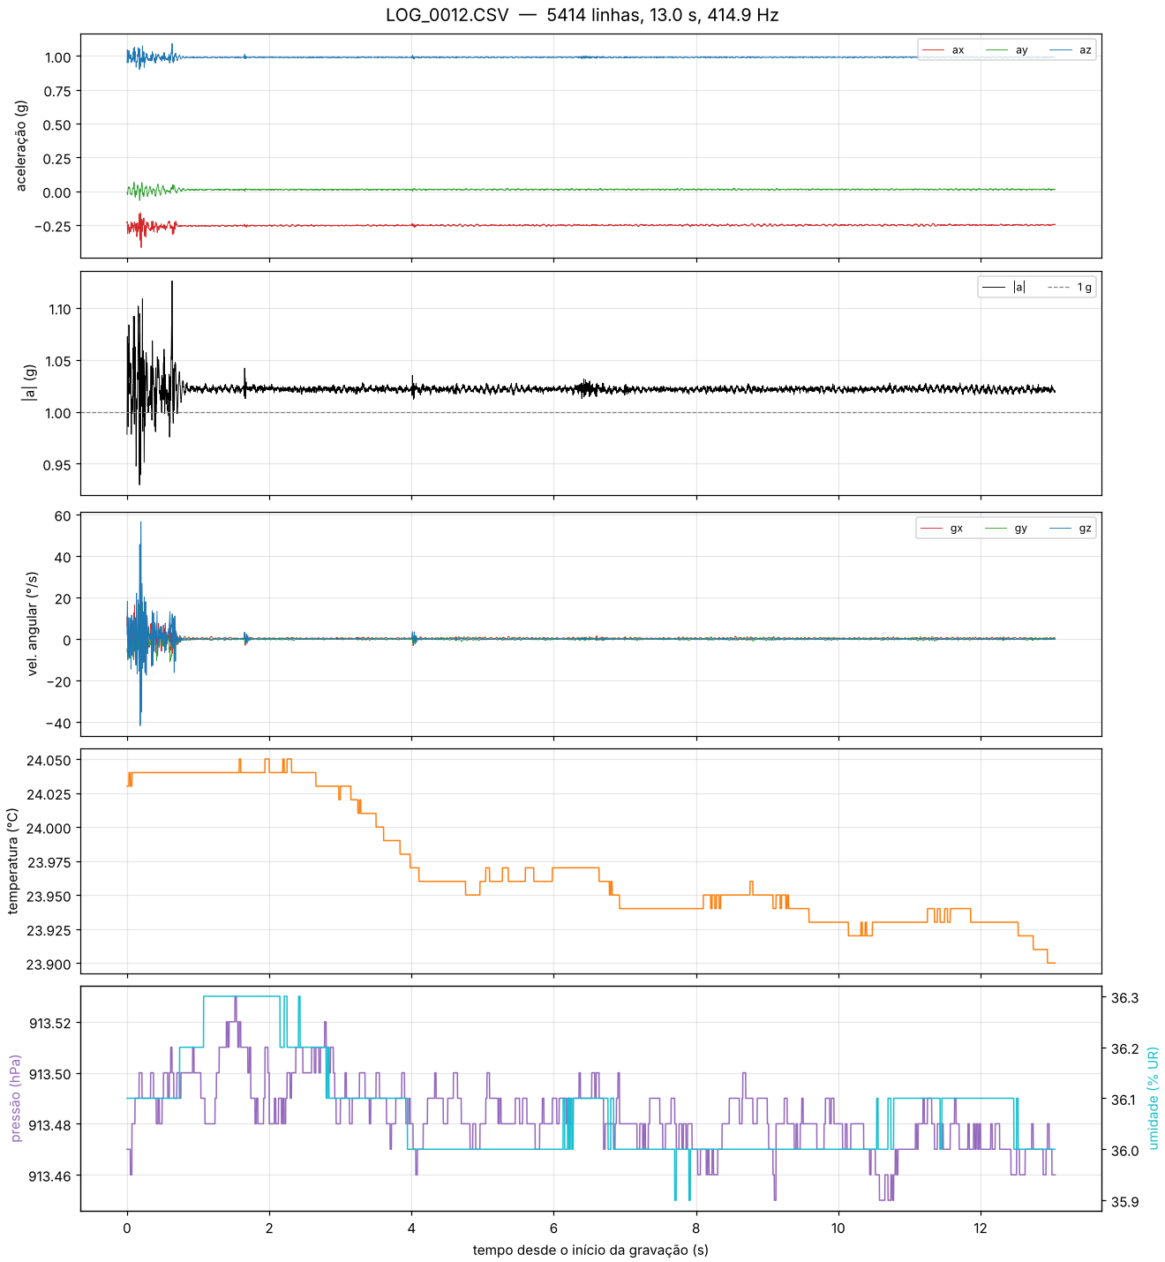
docs/testes/graficos/LOG_0012.png
