carlosoliveirajesus/datalogger/(list of files, drawings)

Other design files:
hardware/datalogger/PCB_A1.PcbDoc
hardware/Datalogger_EPTA/Datalogger_EPTA.PrjPcb
hardware/Datalogger_EPTA/PCB_A1.SchDoc
hw-datalogger/datalogger/00_Top.SchDoc
hw-datalogger/datalogger/01_Power.SchDoc
hw-datalogger/datalogger/02_MCU.SchDoc
hw-datalogger/datalogger/03_Sensors.SchDoc
hw-datalogger/datalogger/04_microSD.SchDoc
hw-datalogger/datalogger/05_Interface.SchDoc
hw-datalogger/datalogger/datalogger.PrjPcb
hw-datalogger/datalogger/PCB_A1.PcbDoc
