carlosoliveirajesus/datalogger/fw-datalogger/datalogger/datalogger.ioc

Mcu.UserName=STM32U5A5ZJTxQ
PA0.GPIO_Label=VBAT_SENSE
PA0.Signal=ADC1_IN5
PA10.GPIO_Label=DBG_RX
PA10.Signal=USART1_RX
PA4.GPIO_Label=IMU_SPI_CS
PA4.Signal=GPIO_Output
PA5.GPIO_Label=IMU_SPI_SCK
PA5.Signal=SPI1_SCK
PA6.GPIO_Label=IMU_SPI_MISO
PA6.Signal=SPI1_MISO
PA7.GPIO_Label=IMU_SPI_MOSI
PA7.Signal=SPI1_MOSI
PA8.GPIO_Label=SD_CD
PA8.Signal=GPIO_Input
PA9.GPIO_Label=DBG_TX
PA9.Signal=USART1_TX
PB1.GPIO_Label=IMU_INT1
PB1.Signal=GPXTI1
PB2.GPIO_Label=IMU_INT2
PB2.Signal=GPXTI2
PB7.GPIO_Label=LED_ERROR
PB7.Signal=GPIO_Output
PB8.GPIO_Label=IMU_I2C_SCL
PB8.Signal=I2C1_SCL
PB9.GPIO_Label=IMU_I2C_SDA
PB9.Signal=I2C1_SDA
PC0.GPIO_Label=BME_SCL
PC0.Signal=I2C3_SCL
PC1.GPIO_Label=BME_SDA
PC1.Signal=I2C3_SDA
PC12.GPIO_Label=SD_CK
PC12.Signal=SDMMC1_CK
PC13.GPIO_Label=BTN
PC13.Signal=GPXTI13
PC7.GPIO_Label=LED_STATUS
PC7.Signal=GPIO_Output
PC8.GPIO_Label=SD_D0
PC8.Signal=SDMMC1_D0
PD2.GPIO_Label=SD_CMD
PD2.Signal=SDMMC1_CMD
