carlosoliveirajesus/datalogger/fw-datalogger/datalogger/port/stm32u5a5/imu.c

/**
 * @file imu.c
 * @brief Port de hal_imu: tabela de chips e barramento do LSM6DSOX.
 *
 * O barramento é escolhido em hal_cfg.h (HAL_IMU_BUS):
 *   SPI: SPI1, modo 3, CS em PA4 (placa final).
 *   I2C: módulo LSM6DSOX montado para I2C (protótipo). Mesma lógica do port
 *        I2C do fw-slamming: HAL_I2C_Mem_Read/Write com endereço de
 *        registrador de 8 bits. O endereço (0x6A ou 0x6B, pino SA0) é
 *        detectado no init.
 *
 * Para adicionar outro chip: criar imu/<chip>.c com a mesma ideia de
 * barramento injetado, uma entrada em HAL_IMU_DEVS (hal_cfg.h) e uma
 * entrada em port_imu_drv[].
 */
#include "main.h"
#include "hal.h"
#include "imu/lsm6dsox.h"

#define IMU_INIT_TRIES    3U
#define IMU_INIT_RETRY_MS 10U

#if HAL_IMU_BUS == HAL_IMU_BUS_SPI
/* ------------------------------------------------ barramento SPI1 */
#include "spi.h"

#define IMU_SPI_TIMEOUT_MS 10U
#define IMU_SPI_READ_BIT   0x80U

static bool lsm6dsox_spi_read(uint8_t reg, uint8_t* data, uint16_t len)
{
    uint8_t addr = (uint8_t) (reg | IMU_SPI_READ_BIT);
    bool ok;

    hal_gpio_set(HAL_GPIO_IMU_CS, false);
    ok = (HAL_SPI_Transmit(&hspi1, &addr, 1, IMU_SPI_TIMEOUT_MS) == HAL_OK) &&
         (HAL_SPI_Receive(&hspi1, data, len, IMU_SPI_TIMEOUT_MS) == HAL_OK);
    hal_gpio_set(HAL_GPIO_IMU_CS, true);

    return ok;
}

static bool lsm6dsox_spi_write(uint8_t reg, const uint8_t* data, uint16_t len)
{
    uint8_t addr = (uint8_t) (reg & ~IMU_SPI_READ_BIT);
    bool ok;

    hal_gpio_set(HAL_GPIO_IMU_CS, false);
    ok = (HAL_SPI_Transmit(&hspi1, &addr, 1, IMU_SPI_TIMEOUT_MS) == HAL_OK) &&
         (HAL_SPI_Transmit(&hspi1, (uint8_t*) data, len, IMU_SPI_TIMEOUT_MS) == HAL_OK);
    hal_gpio_set(HAL_GPIO_IMU_CS, true);

    return ok;
}

static const lsm6dsox_bus_t lsm6dsox_bus = {
    .read = lsm6dsox_spi_read,
    .write = lsm6dsox_spi_write,
    .delay_ms = HAL_Delay,
    .is_spi = true,
};

static bool imu_bus_prepare(void)
{
    return true; /* nada a detectar em SPI */
}

static void imu_bus_print(void)
{
    UTL_DBG_PRINTF(UTL_DBG_MOD_IMU, "LSM6DSOX em SPI1\r\n");
}

static void imu_bus_recover(void)
{
    /* SPI não trava como o I2C: o CS sobe no fim de cada transferência. */
}

#elif HAL_IMU_BUS == HAL_IMU_BUS_I2C
/* ------------------------------------------------- barramento I2C */
#include "i2c.h"

/* Handle do I2C da IMU. Padrão: I2C1 no conector Arduino da Nucleo
 * (PB8 = D15 SCL, PB9 = D14 SDA), que precisa ser habilitado no CubeMX.
 * Alternativa sem mexer no CubeMX: hi2c3, o mesmo barramento do BME280
 * (PC0/PC1); os endereços não colidem (0x6A/0x6B contra 0x76/0x77).
 * Ao trocar o handle, troque junto a função de init e os pinos usados para
 * destravar o barramento (imu_bus_recover). */
#ifndef IMU_I2C_HANDLE
#define IMU_I2C_HANDLE        hi2c1
#define IMU_I2C_INIT          MX_I2C1_Init
#define IMU_I2C_SCL_PORT      IMU_I2C_SCL_GPIO_Port
#define IMU_I2C_SCL_PIN       IMU_I2C_SCL_Pin
#define IMU_I2C_SDA_PORT      IMU_I2C_SDA_GPIO_Port
#define IMU_I2C_SDA_PIN       IMU_I2C_SDA_Pin
#endif

#define IMU_I2C_TIMEOUT_MS 10U
#define IMU_I2C_PROBE_TRIES 3U
#define IMU_I2C_RECOVER_CLOCKS 9U

static uint8_t imu_i2c_addr = 0; /* 7 bits; 0 = não detectado */

static void imu_wait_us(uint32_t us)
{
    uint64_t t0 = hal_time_get_us();

    while((hal_time_get_us() - t0) < us)
    {
    }
}

/* Destrava o I2C da IMU, como port_env_i2c_recover() faz no BME280. Um
   transiente no meio de uma leitura (ex.: vibração forte nos jumpers) pode
   deixar o LSM6DSOX segurando o SDA em 0 esperando clocks que não vêm; daí
   em diante toda leitura dá timeout. Aqui o SCL vira GPIO e recebe até 9
   pulsos até o SDA soltar, sai um STOP e o periférico é reiniciado. */
static void imu_bus_recover(void)
{
    GPIO_InitTypeDef g = { 0 };

    (void) HAL_I2C_DeInit(&IMU_I2C_HANDLE);

    HAL_GPIO_WritePin(IMU_I2C_SCL_PORT, IMU_I2C_SCL_PIN, GPIO_PIN_SET);
    HAL_GPIO_WritePin(IMU_I2C_SDA_PORT, IMU_I2C_SDA_PIN, GPIO_PIN_SET);
    g.Mode = GPIO_MODE_OUTPUT_OD;
    g.Pull = GPIO_NOPULL;
    g.Speed = GPIO_SPEED_FREQ_LOW;
    g.Pin = IMU_I2C_SCL_PIN;
    HAL_GPIO_Init(IMU_I2C_SCL_PORT, &g);
    g.Pin = IMU_I2C_SDA_PIN;
    HAL_GPIO_Init(IMU_I2C_SDA_PORT, &g); /* OD em 1 = solto, dá para ler */

    for(uint32_t n = 0;
        n < IMU_I2C_RECOVER_CLOCKS && HAL_GPIO_ReadPin(IMU_I2C_SDA_PORT, IMU_I2C_SDA_PIN) == GPIO_PIN_RESET; n++)
    {
        HAL_GPIO_WritePin(IMU_I2C_SCL_PORT, IMU_I2C_SCL_PIN, GPIO_PIN_RESET);
        imu_wait_us(5);
        HAL_GPIO_WritePin(IMU_I2C_SCL_PORT, IMU_I2C_SCL_PIN, GPIO_PIN_SET);
        imu_wait_us(5);
    }

    /* STOP: SDA sobe com SCL alto. */
    HAL_GPIO_WritePin(IMU_I2C_SDA_PORT, IMU_I2C_SDA_PIN, GPIO_PIN_RESET);
    imu_wait_us(5);
    HAL_GPIO_WritePin(IMU_I2C_SCL_PORT, IMU_I2C_SCL_PIN, GPIO_PIN_SET);
    imu_wait_us(5);
    HAL_GPIO_WritePin(IMU_I2C_SDA_PORT, IMU_I2C_SDA_PIN, GPIO_PIN_SET);
    imu_wait_us(5);

    IMU_I2C_INIT(); /* gerado pelo CubeMX: volta os pinos para AF do I2C */
}

static bool lsm6dsox_i2c_read(uint8_t reg, uint8_t* data, uint16_t len)
{
    return HAL_I2C_Mem_Read(&IMU_I2C_HANDLE, (uint16_t) (imu_i2c_addr << 1), reg, I2C_MEMADD_SIZE_8BIT, data, len,
                            IMU_I2C_TIMEOUT_MS) == HAL_OK;
}

static bool lsm6dsox_i2c_write(uint8_t reg, const uint8_t* data, uint16_t len)
{
    return HAL_I2C_Mem_Write(&IMU_I2C_HANDLE, (uint16_t) (imu_i2c_addr << 1), reg, I2C_MEMADD_SIZE_8BIT,
                             (uint8_t*) data, len, IMU_I2C_TIMEOUT_MS) == HAL_OK;
}

static const lsm6dsox_bus_t lsm6dsox_bus = {
    .read = lsm6dsox_i2c_read,
    .write = lsm6dsox_i2c_write,
    .delay_ms = HAL_Delay,
    .is_spi = false,
};

/* Procura o chip em 0x6A (SA0 em GND) e depois em 0x6B (SA0 em VDD). */
static bool imu_bus_prepare(void)
{
    static const uint8_t addrs[] = { LSM6DSOX_I2C_ADDR_SA0_LOW, LSM6DSOX_I2C_ADDR_SA0_HIGH };

    imu_i2c_addr = 0;

    for(size_t n = 0; n < UTL_ARRAY_SIZE(addrs); n++)
    {
        if(HAL_I2C_IsDeviceReady(&IMU_I2C_HANDLE, (uint16_t) (addrs[n] << 1), IMU_I2C_PROBE_TRIES,
                                 IMU_I2C_TIMEOUT_MS) == HAL_OK)
        {
            imu_i2c_addr = addrs[n];
            return true;
        }
    }

    UTL_DBG_PRINTF(UTL_DBG_MOD_IMU, "LSM6DSOX nao respondeu em I2C (0x%02X/0x%02X)\r\n", LSM6DSOX_I2C_ADDR_SA0_LOW,
                   LSM6DSOX_I2C_ADDR_SA0_HIGH);
    return false;
}

static void imu_bus_print(void)
{
    UTL_DBG_PRINTF(UTL_DBG_MOD_IMU, "LSM6DSOX em I2C @0x%02X\r\n", imu_i2c_addr);
}

#else
#error "HAL_IMU_BUS deve ser HAL_IMU_BUS_SPI ou HAL_IMU_BUS_I2C (hal_cfg.h)"
#endif

static lsm6dsox_t lsm6dsox_dev;

/* --------------------------------------- adaptadores do LSM6DSOX */

static bool port_lsm6dsox_init(void)
{
    uint8_t id = 0;
    bool ok;

    imu_bus_recover();

    if(!imu_bus_prepare())
        return false;

    imu_bus_print();

    /* Até 3 tentativas: depois de um reset do MCU no meio da operação, a
       primeira às vezes falha e a seguinte funciona. */
    ok = false;
    for(uint32_t n = 1; n <= IMU_INIT_TRIES && !ok; n++)
    {
        ok = lsm6dsox_init(&lsm6dsox_dev, &lsm6dsox_bus);
        if(!ok)
        {
            UTL_DBG_PRINTF(UTL_DBG_MOD_IMU, "LSM6DSOX init tentativa %lu falhou no passo %u\r\n", (unsigned long) n,
                           (unsigned) lsm6dsox_dev.fail_step);
            HAL_Delay(IMU_INIT_RETRY_MS);
        }
    }

    (void) lsm6dsox_who_am_i_get(&lsm6dsox_dev, &id);
    UTL_DBG_PRINTF(UTL_DBG_MOD_IMU, "LSM6DSOX WHO_AM_I=0x%02X (esperado 0x%02X) %s\r\n", id,
                   LSM6DSOX_WHO_AM_I_VALUE, ok ? "OK" : "FALHA");

    return ok;
}

static void port_lsm6dsox_deinit(void)
{
    lsm6dsox_deinit(&lsm6dsox_dev);
}

static bool port_lsm6dsox_is_initialized(void)
{
    return lsm6dsox_dev.initialized;
}

static bool port_lsm6dsox_setup(const hal_imu_config_t* cfg)
{
    /* hal_imu_odr_t e as faixas da HAL usam a mesma numeração do driver. */
    bool ok = lsm6dsox_setup(&lsm6dsox_dev, (uint8_t) cfg->odr, (lsm6dsox_xl_fs_t) cfg->accel_fs,
                             (lsm6dsox_g_fs_t) cfg->gyro_fs, cfg->drdy_int1);

    UTL_DBG_PRINTF(UTL_DBG_MOD_IMU, "LSM6DSOX setup %s\r\n", ok ? "OK" : "FALHA");

    return ok;
}

static bool port_lsm6dsox_raw_read(hal_imu_raw_t* accel, hal_imu_raw_t* gyro)
{
    lsm6dsox_raw_t a;
    lsm6dsox_raw_t g;

    if(!lsm6dsox_raw_read(&lsm6dsox_dev, &a, &g))
        return false;

    accel->x = a.x;
    accel->y = a.y;
    accel->z = a.z;
    gyro->x = g.x;
    gyro->y = g.y;
    gyro->z = g.z;

    return true;
}

static float port_lsm6dsox_accel_scale_get(void)
{
    return lsm6dsox_dev.accel_scale;
}

static float port_lsm6dsox_gyro_scale_get(void)
{
    return lsm6dsox_dev.gyro_scale;
}

/* ------------------------------------------------- tabela de chips */

typedef struct port_imu_driver_s
{
    bool (*init)(void);
    void (*deinit)(void);
    bool (*is_initialized)(void);
    bool (*setup)(const hal_imu_config_t* config);
    bool (*raw_read)(hal_imu_raw_t* accel, hal_imu_raw_t* gyro);
    float (*accel_scale_get)(void);
    float (*gyro_scale_get)(void);
} port_imu_driver_t;

static const port_imu_driver_t port_imu_drv[HAL_IMU_NUM_DEVS] = {
    [HAL_IMU_DEV_LSM6DSOX] = {
        .init = port_lsm6dsox_init,
        .deinit = port_lsm6dsox_deinit,
        .is_initialized = port_lsm6dsox_is_initialized,
        .setup = port_lsm6dsox_setup,
        .raw_read = port_lsm6dsox_raw_read,
        .accel_scale_get = port_lsm6dsox_accel_scale_get,
        .gyro_scale_get = port_lsm6dsox_gyro_scale_get,
    },
};

/* ------------------------------------- despacho genérico (HAL_IMU_DRIVER) */

static bool port_imu_ready(hal_imu_dev_t dev)
{
    return dev < HAL_IMU_NUM_DEVS && port_imu_drv[dev].is_initialized && port_imu_drv[dev].is_initialized();
}

static bool port_imu_init(hal_imu_dev_t dev)
{
    if(dev >= HAL_IMU_NUM_DEVS || port_imu_drv[dev].init == NULL)
        return false;

    return port_imu_drv[dev].init();
}

static void port_imu_deinit(hal_imu_dev_t dev)
{
    if(dev < HAL_IMU_NUM_DEVS && port_imu_drv[dev].deinit)
        port_imu_drv[dev].deinit();
}

static bool port_imu_setup(hal_imu_dev_t dev, const hal_imu_config_t* config)
{
    if(!port_imu_ready(dev) || port_imu_drv[dev].setup == NULL || config == NULL)
        return false;

    return port_imu_drv[dev].setup(config);
}

static bool port_imu_raw_read(hal_imu_dev_t dev, hal_imu_raw_t* accel, hal_imu_raw_t* gyro)
{
    if(!port_imu_ready(dev) || port_imu_drv[dev].raw_read == NULL)
        return false;

    return port_imu_drv[dev].raw_read(accel, gyro);
}

static float port_imu_accel_scale_get(hal_imu_dev_t dev)
{
    return port_imu_ready(dev) && port_imu_drv[dev].accel_scale_get ? port_imu_drv[dev].accel_scale_get() : 0.0f;
}

static float port_imu_gyro_scale_get(hal_imu_dev_t dev)
{
    return port_imu_ready(dev) && port_imu_drv[dev].gyro_scale_get ? port_imu_drv[dev].gyro_scale_get() : 0.0f;
}

hal_imu_driver_t HAL_IMU_DRIVER = {
    .init = port_imu_init,
    .deinit = port_imu_deinit,
    .setup = port_imu_setup,
    .raw_read = port_imu_raw_read,
    .accel_scale_get = port_imu_accel_scale_get,
    .gyro_scale_get = port_imu_gyro_scale_get,
};
