carlosoliveirajesus/datalogger/fw-datalogger/datalogger/port/stm32u5a5/imu/lsm6dsox.h

/**
 * @file lsm6dsox.h
 * @brief Driver do LSM6DSOX (ST), independente do barramento.
 *
 * O acesso ao barramento é injetado pelo port (lsm6dsox_bus_t), então o
 * mesmo driver serve para SPI ou I2C. Referência: datasheet LSM6DSOX DS12814.
 */
#pragma once

#include <stdint.h>
#include <stdbool.h>

#define LSM6DSOX_WHO_AM_I_VALUE 0x6C

/* Endereços I2C de 7 bits, conforme o pino SA0/SDO (DS12814, 6.3). */
#define LSM6DSOX_I2C_ADDR_SA0_LOW  0x6A
#define LSM6DSOX_I2C_ADDR_SA0_HIGH 0x6B

/* Registradores usados (DS12814, seção 8). */
#define LSM6DSOX_REG_COUNTER_BDR_REG1 0x0B
#define LSM6DSOX_REG_INT1_CTRL 0x0D
#define LSM6DSOX_REG_WHO_AM_I  0x0F
#define LSM6DSOX_REG_CTRL1_XL  0x10
#define LSM6DSOX_REG_CTRL2_G   0x11
#define LSM6DSOX_REG_CTRL3_C   0x12
#define LSM6DSOX_REG_CTRL4_C   0x13
#define LSM6DSOX_REG_STATUS    0x1E
#define LSM6DSOX_REG_OUTX_L_G  0x22
#define LSM6DSOX_REG_OUTX_L_A  0x28

#define LSM6DSOX_CTRL3_C_BOOT     (1U << 7)
#define LSM6DSOX_CTRL3_C_BDU      (1U << 6)
#define LSM6DSOX_CTRL3_C_IF_INC   (1U << 2)
#define LSM6DSOX_CTRL3_C_SW_RESET (1U << 0)
#define LSM6DSOX_CTRL4_C_I2C_DIS  (1U << 2)
#define LSM6DSOX_DATAREADY_PULSED (1U << 7) /* COUNTER_BDR_REG1 (não usado: ver lsm6dsox_setup) */
#define LSM6DSOX_INT1_DRDY_XL     (1U << 0) /* INT1_CTRL */

/* ODR (CTRL1_XL/CTRL2_G [7:4]): 0 = power-down, 1..8 = 12,5 / 26 / 52 /
   104 / 208 / 416 / 833 / 1666 Hz (DS12814, tabelas 52 e 55). */
#define LSM6DSOX_ODR_MAX 8

/* Faixas. Os códigos dos registradores não seguem a ordem das faixas
   (FS_XL: 00 = 2 g, 01 = 16 g, 10 = 4 g, 11 = 8 g), por isso a API usa
   estes enums e o driver traduz. */
typedef enum lsm6dsox_xl_fs_e
{
    LSM6DSOX_XL_2G = 0,
    LSM6DSOX_XL_4G,
    LSM6DSOX_XL_8G,
    LSM6DSOX_XL_16G,
} lsm6dsox_xl_fs_t;

typedef enum lsm6dsox_g_fs_e
{
    LSM6DSOX_G_125DPS = 0,
    LSM6DSOX_G_250DPS,
    LSM6DSOX_G_500DPS,
    LSM6DSOX_G_1000DPS,
    LSM6DSOX_G_2000DPS,
} lsm6dsox_g_fs_t;

typedef struct lsm6dsox_raw_s
{
    int16_t x;
    int16_t y;
    int16_t z;
} lsm6dsox_raw_t;

typedef struct lsm6dsox_bus_s
{
    bool (*read)(uint8_t reg, uint8_t* data, uint16_t len);
    bool (*write)(uint8_t reg, const uint8_t* data, uint16_t len);
    void (*delay_ms)(uint32_t ms);
    bool is_spi; /**< true: desliga a interface I2C do chip no init */
} lsm6dsox_bus_t;

typedef struct lsm6dsox_s
{
    const lsm6dsox_bus_t* bus;
    float accel_scale; /**< g/LSB   */
    float gyro_scale;  /**< dps/LSB */
    bool initialized;
    bool configured;
    uint8_t fail_step; /**< onde o último init falhou (LSM6DSOX_STEP_*), 0 = ok */
} lsm6dsox_t;

/* Passos do lsm6dsox_init(), para diagnóstico. */
#define LSM6DSOX_STEP_I2C_DIS    1
#define LSM6DSOX_STEP_WHO_AM_I   2
#define LSM6DSOX_STEP_POWER_DOWN 3
#define LSM6DSOX_STEP_SW_RESET   4
#define LSM6DSOX_STEP_RESET_WAIT 5
#define LSM6DSOX_STEP_CONFIG     6

/**
 * Confere o WHO_AM_I e faz reset por software. Em SPI (bus->is_spi) também
 * desliga a interface I2C do chip; em I2C ela fica ligada, claro.
 */
bool lsm6dsox_init(lsm6dsox_t* dev, const lsm6dsox_bus_t* bus);
void lsm6dsox_deinit(lsm6dsox_t* dev);
bool lsm6dsox_who_am_i_get(lsm6dsox_t* dev, uint8_t* id);

/**
 * Liga acc e gyro no mesmo ODR e configura as faixas. Com drdy_int1, o pino
 * INT1 sobe a cada amostra nova do acelerômetro e fica alto até a leitura
 * (data-ready travado), adequado para EXTI por borda de subida.
 */
bool lsm6dsox_setup(lsm6dsox_t* dev, uint8_t odr, lsm6dsox_xl_fs_t xl_fs, lsm6dsox_g_fs_t g_fs, bool drdy_int1);

/** Lê gyro e acc numa única leitura de 12 bytes (OUTX_L_G..OUTZ_H_A). */
bool lsm6dsox_raw_read(lsm6dsox_t* dev, lsm6dsox_raw_t* accel, lsm6dsox_raw_t* gyro);
