carlosoliveirajesus/datalogger/fw-datalogger/datalogger/hal/src/hal_gpio.c

#include "hal.h"

#if HAL_GPIO_ENABLED == 1

static hal_gpio_driver_t* drv = &HAL_GPIO_DRIVER;

void hal_gpio_configure(hal_gpio_pin_t pin, hal_gpio_mode_t mode, hal_gpio_speed_t speed, hal_gpio_pull_t pull)
{
    drv->configure(pin, mode, speed, pull);
}

void hal_gpio_interrupt_cbk_set(hal_gpio_pin_t pin, hal_gpio_cbk_t cbk)
{
    drv->interrupt_cbk_set(pin, cbk);
}

void hal_gpio_interrupt_set(hal_gpio_pin_t pin, hal_gpio_interrupt_state_t state)
{
    drv->interrupt_set(pin, state);
}

void hal_gpio_set(hal_gpio_pin_t pin, bool state)
{
    drv->set(pin, state);
}

bool hal_gpio_get(hal_gpio_pin_t pin)
{
    return drv->get(pin);
}

void hal_gpio_toggle(hal_gpio_pin_t pin)
{
    drv->toggle(pin);
}

void hal_gpio_interrupt_trigger(hal_gpio_pin_t pin)
{
    drv->interrupt_trigger(pin);
}

#endif
