carlosoliveirajesus/datalogger/(commit log)

2026-10-15 Configura o .ioc da Nucleo e move projetos para fw-/hw-datalogger
    - Pinagem e perifericos no CubeMX (validos tambem no LQFP64 da PCB):
    SDMMC1 4 bits (CLK48/HSI48, 12 MHz, pull-ups), SPI1 modo 3 a 5 MHz
    (PA5/PA6/PA7, CS em PA4), I2C3 em PC0/PC1, USART1 de debug,
    EXTI para IMU_INT1/INT2 e botao, ADC1 IN5 + Vrefint.
    - Clock: HSE 16 MHz -> PLL1 -> 160 MHz; regulador SMPS; LSE no RTC.
    - Codigo gerado com um .c/.h por periferico.
    - Pastas renomeadas: firmware/ -> fw-datalogger/, hardware/ -> hw-datalogger/;
    README atualizado.
    Claude-Session: https://claude.ai/code/session_01Gv4yQvQNvLYJtaCWXcigwQ
2026-10-22 hw: arquivos de Output para fabricacao e atualizacao README.
2026-10-23 fw: LSM6DSOX selecionavel entre SPI e I2C (HAL_IMU_BUS).
2026-10-24 fw: SD em SDMMC 1 bit (BFF Adafruit), card detect opcional e diagnostico de init.
2026-10-24 fw: LSM6DSOX com ODR/faixas, data-ready pulsado no INT1 e leitura de 12 bytes.
2026-10-24 fw: logger CSV completo, gravacao pelo botao e recuperacao de sensores
    Logger
    - CSV com uma linha por amostra da IMU (~415 Hz): t_ms, acc (g), gyro (dps),
    temp_c, press_hpa, hum_rh; ultima leitura do BME280 repetida em cada linha
    - Buffer circular de 1024 amostras preenchido na ISR, escrita em blocos de
    512 B e f_sync a cada 1 s; formatacao inteira, sem printf
    - Colunas do BME280 vazias enquanto nao houver leitura valida
    - Gravacao comeca e termina pelo botao B1, um LOG_nnnn.CSV por gravacao
    (antes: um arquivo por boot); cartao pode ser removido no estado IDLE
    IMU (LSM6DSOX)
    - Data-ready travado no INT1 (PB1 com pull-down) e resgate por software
    (EXTI SWIER1) se o pino ficar parado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
2026-10-24 docs: referencias completas (datasheets, bibliotecas e licencas) e secao de firmware/temporizacao no README.
2026-10-24 fw/docs: SD sem travar ao recolocar o cartao e registro dos testes
    Firmware
    - HAL do SD com timeouts finitos: SDMMC_DATATIMEOUT=5000000U e
    SDMMC_SWDATATIMEOUT=1000U nos simbolos do compilador (.cproject, Debug e
    Release); os padroes 0xFFFFFFFF travavam o HAL_SD_Init() ao recolocar o
    cartao. _Static_assert em sd.c impede compilar sem eles
    - port_sd_deinit() reseta o SDMMC1 pelo RCC antes de cada nova tentativa
    Testes
    - docs/testes/: CSVs reais do cartao (LOG_0001 a LOG_0012), logs da UART
    de cada gravacao (LOG_0002 em diante) e logs de bring-up, com indice
    - Remocao do cartao: arquivos integros ate o ultimo f_sync (LOG_0007-0009);
    removido e recolocado 2x sem reset, gravacao retoma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
2026-10-24 docs: validacao da IMU em repouso e da pressao (METAR SBUL e topografia do bloco 1E/UFU).
2026-10-25 docs: BOM com justificativas e precos Mouser, fotos do prototipo, maquina de estados e status de entrega no README.
2026-10-25 docs: apresentacao em PDF, status final no README e correcao D1/Q1 na BOM.
2026-10-25 docs: BOM abre no topo (painel congelado so no cabecalho); fw: gerar .bin no build Release.
